dcollens/ZED-80/src/zed-80/lcdsample/README.txt

This folder has the cleaned-up source code for the LCD sample program provided by the panel
manufacturer. The results of running the sample code through the C preprocessor are in RA8876.pp
and can be used to study how the sample program configures the RA8876 registers to achieve
various results.
