dcollens/ZED-80/orders/51846558.xlsx

# | Quantity | Part Number | Manufacturer Part Number | Description | Customer Reference | Backorder | Unit Price | Extended Price
1 | 1 | 269-3898-ND | Z84C0010PEG | IC MPU Z80 10MHZ 40DIP |  | 0 | 7.71 | 7.71
2 | 2 | SST39SF010A-70-4C-PHE-ND | SST39SF010A-70-4C-PHE | IC FLASH 1MBIT 70NS 32DIP |  | 0 | 2.23 | 4.46
3 | 2 | 535-9167-5-ND | ACH-10.000MHZ-EK | OSC XO 10.000MHZ TTL PC PIN |  | 0 | 2.38 | 4.76
4 | 2 | 296-4550-5-ND | SN74AHC14N | IC HEX SCHMITT-TRIG INV 14-DIP |  | 0 | 0.78 | 1.56
5 | 20 | BC2665CT-ND | K104K10X7RF5UH5 | CAP CER 0.1UF 50V X7R RADIAL |  | 0 | 0.177 | 3.54
6 | 10 | BC2662CT-ND | K103K10X7RF5UH5 | CAP CER 10000PF 50V X7R RADIAL |  | 0 | 0.145 | 1.45
7 | 1 | EG4791-ND | KS-01Q-01 | SWITCH PUSH SPST-NO 0.01A 35V |  | 0 | 0.76 | 0.76
8 | 1 | EG4792-ND | KS-01Q-02 | SWITCH PUSH SPST-NO 0.01A 35V |  | 0 | 0.76 | 0.76
9 | 1 | EG4793-ND | KS-01Q-03 | SWITCH PUSH SPST-NO 0.01A 35V |  | 0 | 0.76 | 0.76
10 | 2 | 1450-1017-ND | AS6C1008-55PCN | IC SRAM 1MBIT 55NS 32DIP |  | 0 | 4.55 | 9.10
11 | 2 | 296-4596-5-ND | SN74AHC32N | IC GATE OR 4CH 2-INP 14-DIP |  | 0 | 0.78 | 1.56
12 | 2 | 160-1927-5-ND | LTD-6940HR | LED 7-SEG 2DIGIT HER 0.56" CC |  | 0 | 2.37 | 4.74
13 | 4 | 296-33651-5-ND | SN74AC574N | IC D-TYPE POS TRG SNGL 20DIP |  | 0 | 1.3 | 5.20
14 | 50 | CF18JT220RCT-ND | CF18JT220R | RES 220 OHM 1/8W 5% CF AXIAL |  | 0 | 0.0392 | 1.96
15 | 2 | 296-4542-5-ND | SN74AHC138N | IC 3-8 LINE DECODR/DEMUX 16-DIP |  | 0 | 0.81 | 1.62
16 | 50 | CF18JT10K0CT-ND | CF18JT10K0 | RES 10K OHM 1/8W 5% CF AXIAL |  | 0 | 0.0392 | 1.96
