dcollens/ZED-80/(list of files, cad)

Other CAD files:
lcd-docs/ER-TFTM101-1_8080-8-Bit_With_RTP_SD_Flash_Fontchip(ER3303-1)_DemoCode/sd.OBJ
lcd-docs/ER-TFTM101-1_8080-8-Bit_With_RTP_SD_Flash_Fontchip(ER3303-1)_DemoCode/RA8876.OBJ
