dcollens/ZED-80/lcd-docs/ER-TP101-1_Drawing.pdf

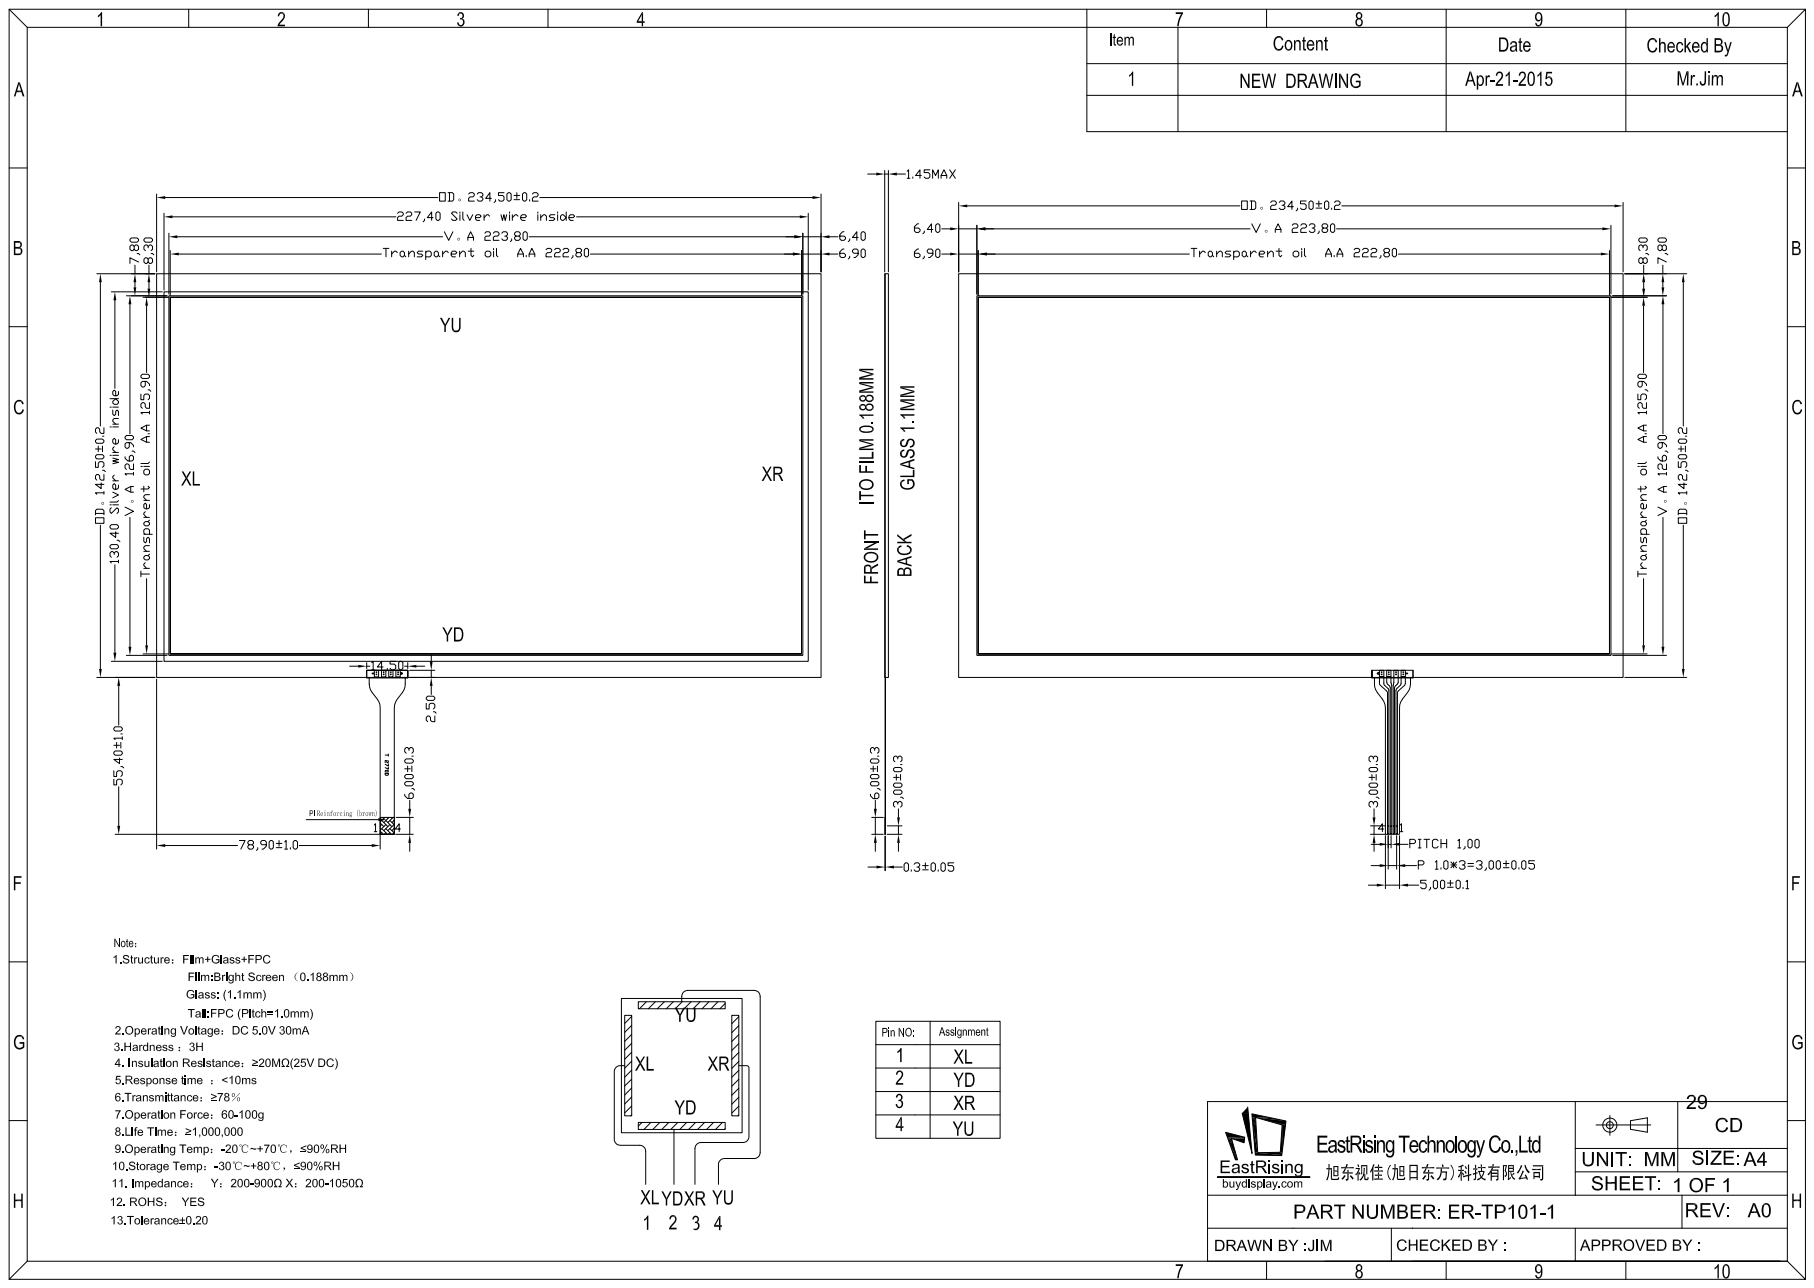
[picture p17: page 1]
