dcollens/ZED-80/kicad/zed-80.kicad_pcb

## KiCad design kicad/zed-80.kicad_pcb (2019-04-16)

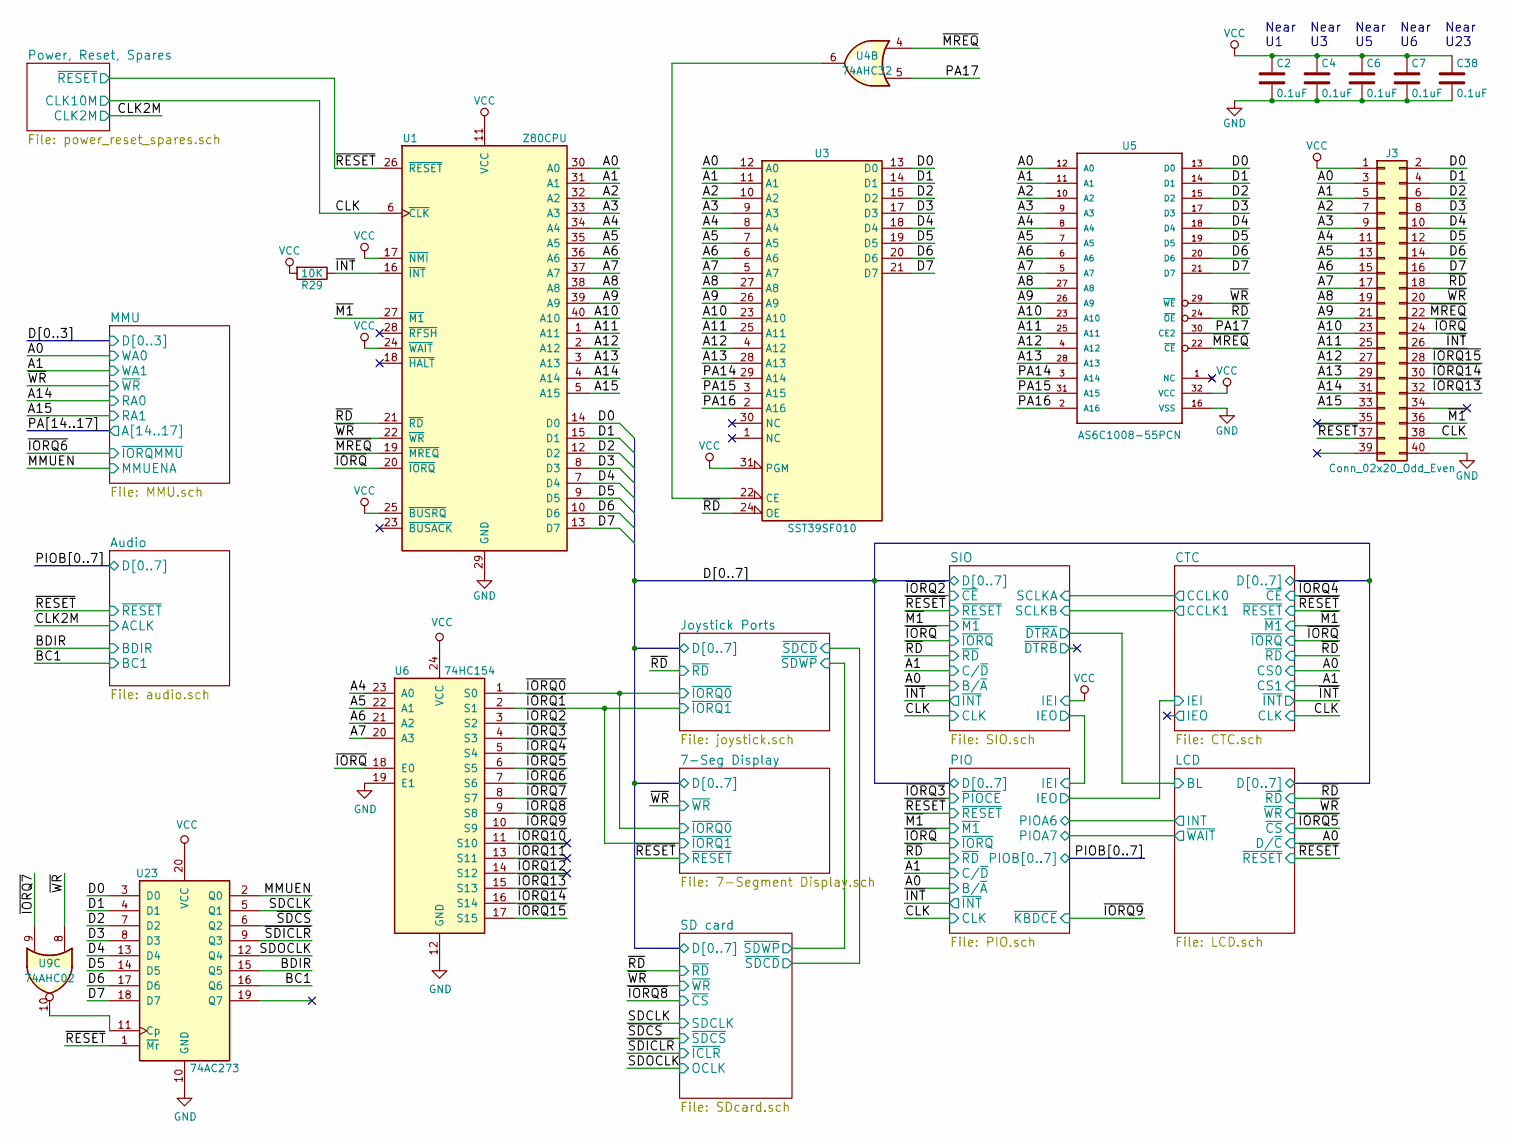
[picture p18: schematic zed-80.sch, ZED-80 Personal Computer]

Parts:
C2, C4, C6, C7, C38: 0.1uF; C_Disc_D4.3mm_W1.9mm_P5.00mm
J3: Conn_02x20_Odd_Even; Pin_Header_Straight_2x20_Pitch2.54mm
R29: 10K; R_0805_HandSoldering
U1: Z80CPU; DIP-40_W15.24mm_Socket
U3: SST39SF010; DIP-32_W15.24mm_Socket
U4: 74AHC32; DIP-14_W7.62mm
U5: AS6C1008-55PCN; DIP-32_W15.24mm_Socket
U6: 74HC154; SOIC-24W_7.5x15.4mm_Pitch1.27mm
U9: 74AHC02; DIP-14_W7.62mm
U23: 74AC273; TSSOP-20_4.4x6.5mm_Pitch0.65mm

Connections:
/A0: J3.3, U1.30 (A0), U3.12 (A0), U5.12 (A0); also elsewhere on the board
/A1: J3.5, U1.31 (A1), U3.11 (A1), U5.11 (A1); also elsewhere on the board
/A2: J3.7, U1.32 (A2), U3.10 (A2), U5.10 (A2)
/A3: J3.9, U1.33 (A3), U3.9 (A3), U5.9 (A3)
/A4: J3.11, U1.34 (A4), U3.8 (A4), U5.8 (A4), U6.23 (A0)
/A5: J3.13, U1.35 (A5), U3.7 (A5), U5.7 (A5), U6.22 (A1)
/A6: J3.15, U1.36 (A6), U3.6 (A6), U5.6 (A6), U6.21 (A2)
/A7: J3.17, U1.37 (A7), U3.5 (A7), U5.5 (A7), U6.20 (A3)
/A8: J3.19, U1.38 (A8), U3.27 (A8), U5.27 (A8)
/A9: J3.21, U1.39 (A9), U3.26 (A9), U5.26 (A9)
/A10: J3.23, U1.40 (A10), U3.23 (A10), U5.23 (A10)
/A11: J3.25, U1.1 (A11), U3.25 (A11), U5.25 (A11)
/A12: J3.27, U1.2 (A12), U3.4 (A12), U5.4 (A12)
/A13: J3.29, U1.3 (A13), U3.28 (A13), U5.28 (A13)
/A14: J3.31, U1.4 (A14); also elsewhere on the board
/A15: J3.33, U1.5 (A15); also elsewhere on the board
/BC1: U23.16 (Q6); also elsewhere on the board
/BDIR: U23.15 (Q5); also elsewhere on the board
/CLK: J3.38, U1.6 (~CLK~); also elsewhere on the board
/D0: J3.2, U1.14 (D0), U3.13 (D0), U5.13 (D0), U23.3 (D0); also elsewhere on the board
/D1: J3.4, U1.15 (D1), U3.14 (D1), U5.14 (D1), U23.4 (D1); also elsewhere on the board
/D2: J3.6, U1.12 (D2), U3.15 (D2), U5.15 (D2), U23.7 (D2); also elsewhere on the board
/D3: J3.8, U1.8 (D3), U3.17 (D3), U5.17 (D3), U23.8 (D3); also elsewhere on the board
/D4: J3.10, U1.7 (D4), U3.18 (D4), U5.18 (D4), U23.13 (D4); also elsewhere on the board
/D5: J3.12, U1.9 (D5), U3.19 (D5), U5.19 (D5), U23.14 (D5); also elsewhere on the board
/D6: J3.14, U1.10 (D6), U3.20 (D6), U5.20 (D6), U23.17 (D6); also elsewhere on the board
/D7: J3.16, U1.13 (D7), U3.21 (D7), U5.21 (D7), U23.18 (D7); also elsewhere on the board
/MMUEN: U23.2 (Q0); also elsewhere on the board
/PA14: U3.29 (A14), U5.3 (A14); also elsewhere on the board
/PA15: U3.3 (A15), U5.31 (A15); also elsewhere on the board
/PA16: U3.2 (A16), U5.2 (A16); also elsewhere on the board
/PA17: U4.5, U5.30 (CE2); also elsewhere on the board
/SDOCLK: U23.12 (Q4); also elsewhere on the board
/~INT: J3.26, R29.1, U1.16 (~INT~); also elsewhere on the board
/~IORQ: J3.24, U1.20 (~IORQ~), U6.18 (E0); also elsewhere on the board
/~IORQ0: U6.1 (S0); also elsewhere on the board
/~IORQ1: U6.2 (S1); also elsewhere on the board
/~IORQ2: U6.3 (S2); also elsewhere on the board
/~IORQ3: U6.4 (S3); also elsewhere on the board
/~IORQ4: U6.5 (S4); also elsewhere on the board
/~IORQ5: U6.6 (S5); also elsewhere on the board
/~IORQ6: U6.7 (S6); also elsewhere on the board
/~IORQ7: U6.8 (S7), U9.9
/~IORQ8: U6.9 (S8); also elsewhere on the board
/~IORQ9: U6.10 (S9); also elsewhere on the board
/~IORQ13: J3.32, U6.15 (S13)
/~IORQ14: J3.30, U6.16 (S14)
/~IORQ15: J3.28, U6.17 (S15)
/~M1: J3.36, U1.27 (~M1~); also elsewhere on the board
/~MREQ: J3.22, U1.19 (~MREQ~), U4.4, U5.22 (~CE)
/~RD: J3.18, U1.21 (~RD~), U3.24 (OE), U5.24 (~OE); also elsewhere on the board
/~RESET: J3.37, U1.26 (~RESET~), U23.1 (~Mr); also elsewhere on the board
/~SDICLR: U23.9 (Q3); also elsewhere on the board
/~WR: J3.20, U1.22 (~WR~), U5.29 (~WE), U9.8; also elsewhere on the board
GND: C2.2, C4.2, C6.2, C7.2, C38.2, J3.40, U1.29 (GND), U3.16 (GND), U5.16 (VSS), U6.12 (GND), U6.19 (E1), U23.10 (GND); also elsewhere on the board
unnamed: U3.22 (CE), U4.6
unnamed: U9.10, U23.11 (Cp)
SDCLK_5V: U23.5 (Q1); also elsewhere on the board
VCC: C2.1, C4.1, C6.1, C7.1, C38.1, J3.1, R29.2, U1.11 (VCC), U1.17 (~NMI~), U1.24 (~WAIT~), U1.25 (~BUSRQ~), U3.31 (PGM), U3.32 (VCC), U5.32 (VCC), U6.24 (VCC), U23.20 (VCC); also elsewhere on the board
~SDCS_5V: U23.6 (Q2); also elsewhere on the board

Notes on the sheet:
Near U1
Near U3
Near U5
Near U6
Near U23

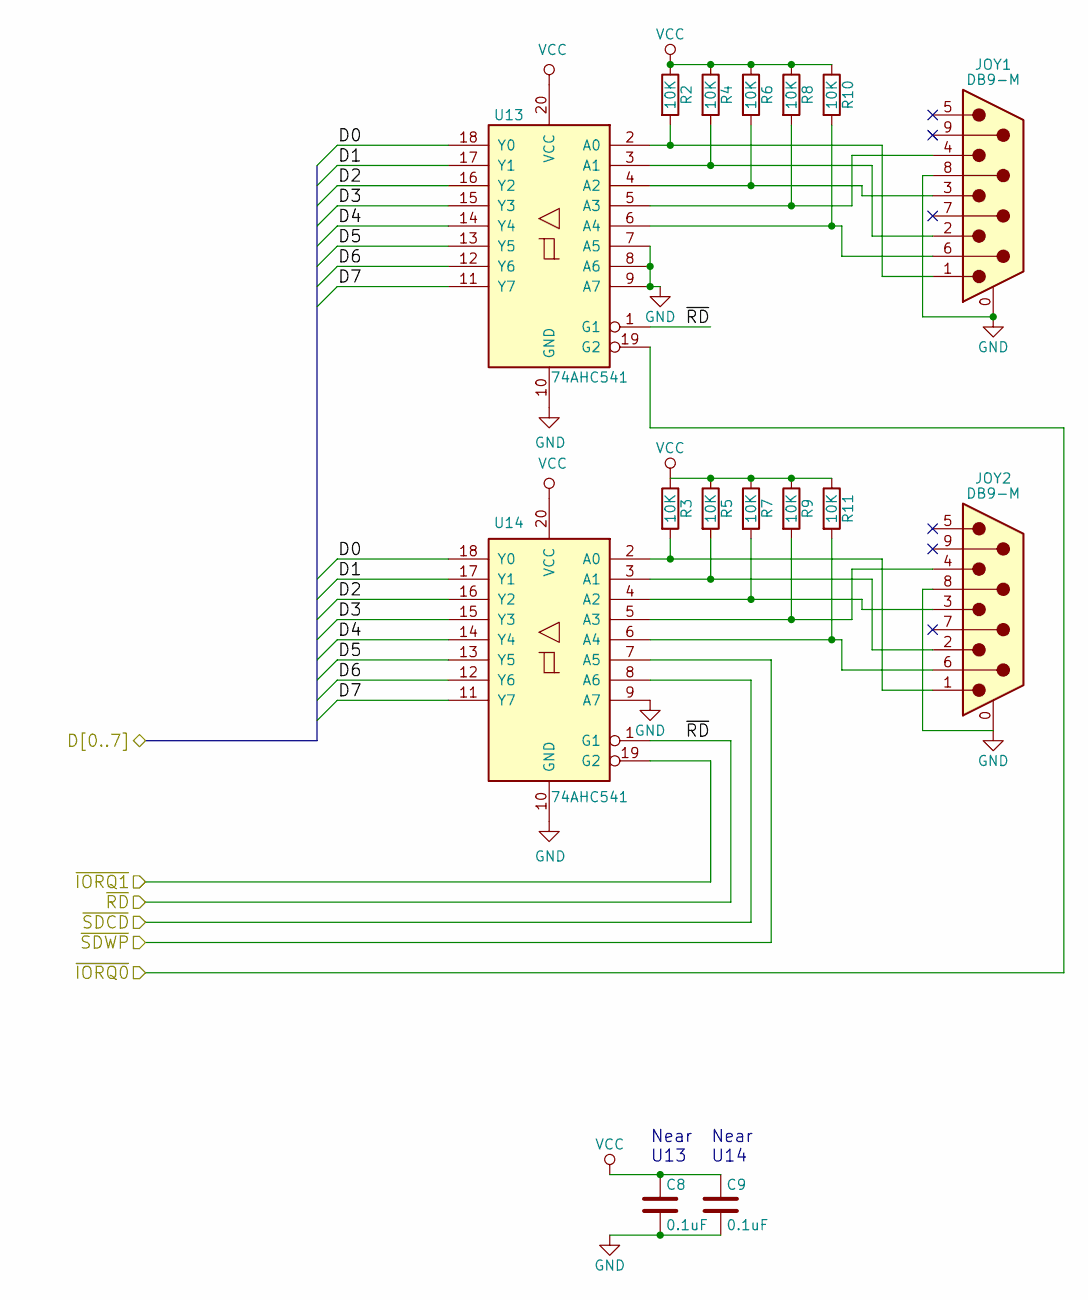
[picture p19: schematic joystick.sch, Joystick Ports]

Parts:
C8, C9: 0.1uF; C_Disc_D4.3mm_W1.9mm_P5.00mm
JOY1, JOY2: DB9-M; L717SDE09P1ACH
R2, R3, R4, R5, R6, R7, R8, R9, R10, R11: 10K; R_0805_HandSoldering
U13, U14: 74AHC541; TSSOP-20_4.4x6.5mm_Pitch0.65mm

Connections:
/D0: U13.18 (Y0), U14.18 (Y0); also elsewhere on the board
/D1: U13.17 (Y1), U14.17 (Y1); also elsewhere on the board
/D2: U13.16 (Y2), U14.16 (Y2); also elsewhere on the board
/D3: U13.15 (Y3), U14.15 (Y3); also elsewhere on the board
/D4: U13.14 (Y4), U14.14 (Y4); also elsewhere on the board
/D5: U13.13 (Y5), U14.13 (Y5); also elsewhere on the board
/D6: U13.12 (Y6), U14.12 (Y6); also elsewhere on the board
/D7: U13.11 (Y7), U14.11 (Y7); also elsewhere on the board
/Joystick Ports/~SDCD: U14.8 (A6); also elsewhere on the board
/Joystick Ports/~SDWP: U14.7 (A5); also elsewhere on the board
/~IORQ0: U13.19 (G2); also elsewhere on the board
/~IORQ1: U14.19 (G2); also elsewhere on the board
/~RD: U13.1 (G1), U14.1 (G1); also elsewhere on the board
GND: C8.2, C9.2, JOY1.0 (PAD), JOY1.8, JOY2.0 (PAD), JOY2.8, U13.7 (A5), U13.8 (A6), U13.9 (A7), U13.10 (GND), U14.9 (A7), U14.10 (GND); also elsewhere on the board
unnamed: JOY1.1, R2.2, U13.2 (A0)
unnamed: JOY1.2, R4.2, U13.3 (A1)
unnamed: JOY1.3, R6.2, U13.4 (A2)
unnamed: JOY1.4, R8.2, U13.5 (A3)
unnamed: JOY1.6, R10.2, U13.6 (A4)
unnamed: JOY2.1, R3.2, U14.2 (A0)
unnamed: JOY2.2, R5.2, U14.3 (A1)
unnamed: JOY2.3, R7.2, U14.4 (A2)
unnamed: JOY2.4, R9.2, U14.5 (A3)
unnamed: JOY2.6, R11.2, U14.6 (A4)
VCC: C8.1, C9.1, R2.1, R3.1, R4.1, R5.1, R6.1, R7.1, R8.1, R9.1, R10.1, R11.1, U13.20 (VCC), U14.20 (VCC); also elsewhere on the board

Notes on the sheet:
Near U13
Near U14

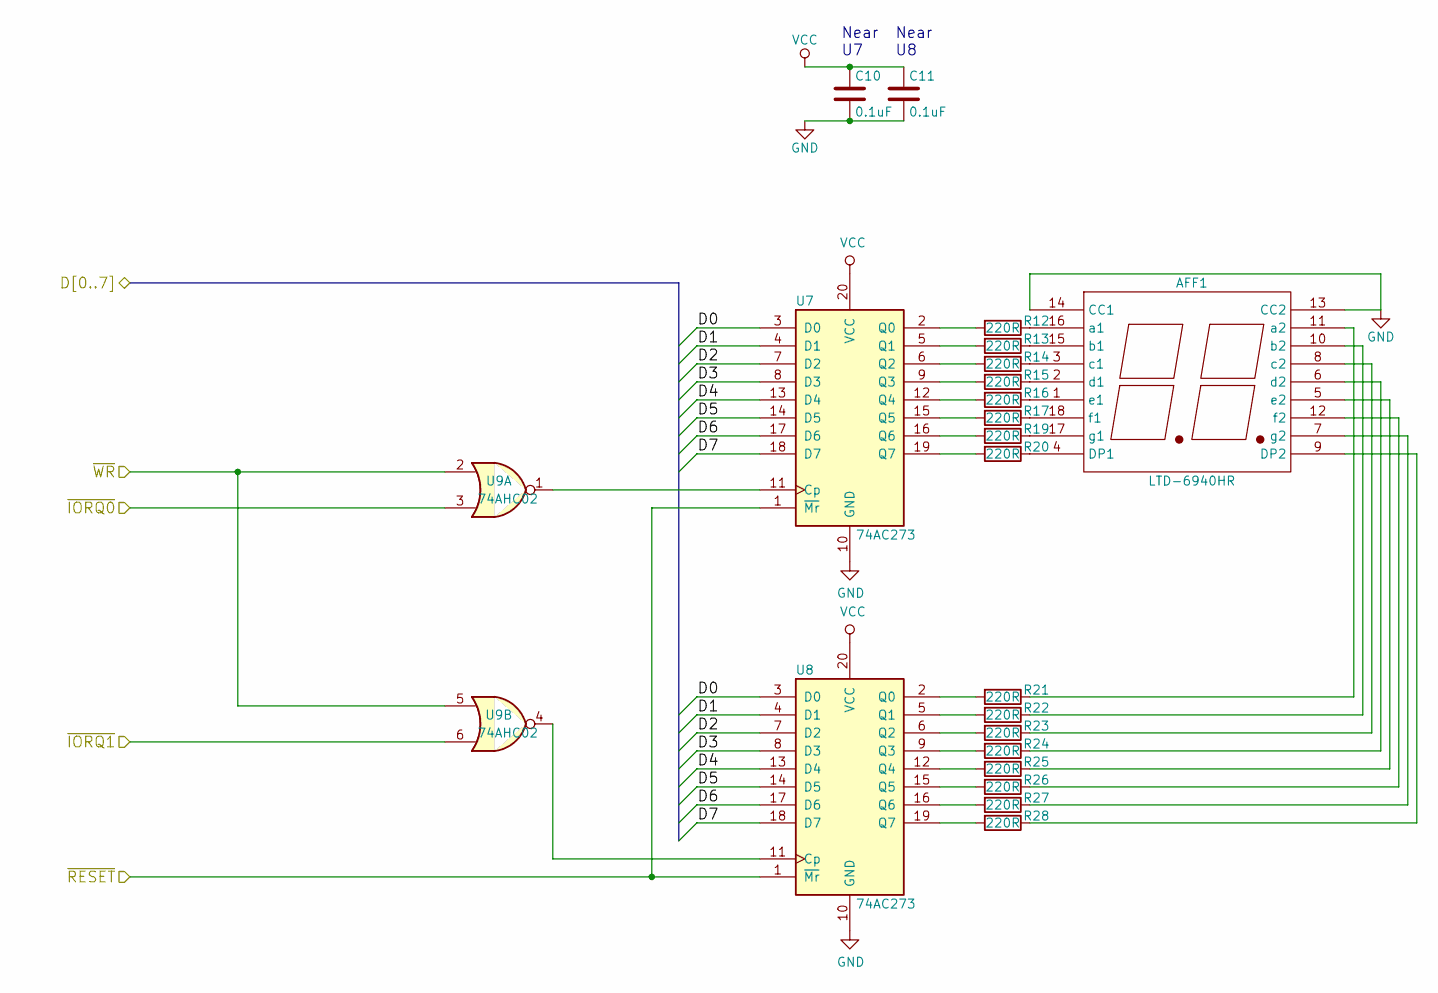
[picture p20: schematic 7-Segment Display.sch]

Parts:
AFF1: LTD-6940HR
C10, C11: 0.1uF; C_Disc_D4.3mm_W1.9mm_P5.00mm
R12, R13, R14, R15, R16, R17, R19, R20, R21, R22, R23, R24, R25, R26, R27, R28: 220R; R_Axial_DIN0204_L3.6mm_D1.6mm_P5.08mm_Horizontal
U7, U8: 74AC273; TSSOP-20_4.4x6.5mm_Pitch0.65mm
U9: 74AHC02; DIP-14_W7.62mm

Connections:
/D0: U7.3 (D0), U8.3 (D0); also elsewhere on the board
/D1: U7.4 (D1), U8.4 (D1); also elsewhere on the board
/D2: U7.7 (D2), U8.7 (D2); also elsewhere on the board
/D3: U7.8 (D3), U8.8 (D3); also elsewhere on the board
/D4: U7.13 (D4), U8.13 (D4); also elsewhere on the board
/D5: U7.14 (D5), U8.14 (D5); also elsewhere on the board
/D6: U7.17 (D6), U8.17 (D6); also elsewhere on the board
/D7: U7.18 (D7), U8.18 (D7); also elsewhere on the board
/~IORQ0: U9.3; also elsewhere on the board
/~IORQ1: U9.6; also elsewhere on the board
/~RESET: U7.1 (~Mr), U8.1 (~Mr); also elsewhere on the board
/~WR: U9.2, U9.5; also elsewhere on the board
GND: AFF1.13 (CC2), AFF1.14 (CC1), C10.2, C11.2, U7.10 (GND), U8.10 (GND); also elsewhere on the board
unnamed: AFF1.1 (e1), R16.1
unnamed: AFF1.2 (d1), R15.1
unnamed: AFF1.3 (c1), R14.1
unnamed: AFF1.4 (DP1), R20.1
unnamed: AFF1.5 (e2), R25.1
unnamed: AFF1.6 (d2), R24.1
unnamed: AFF1.7 (g2), R27.1
unnamed: AFF1.8 (c2), R23.1
unnamed: AFF1.9 (DP2), R28.1
unnamed: AFF1.10 (b2), R22.1
unnamed: AFF1.11 (a2), R21.1
unnamed: AFF1.12 (f2), R26.1
unnamed: AFF1.15 (b1), R13.1
unnamed: AFF1.16 (a1), R12.1
unnamed: AFF1.17 (g1), R19.1
unnamed: AFF1.18 (f1), R17.1
unnamed: R12.2, U7.2 (Q0)
unnamed: R13.2, U7.5 (Q1)
unnamed: R14.2, U7.6 (Q2)
unnamed: R15.2, U7.9 (Q3)
unnamed: R16.2, U7.12 (Q4)
unnamed: R17.2, U7.15 (Q5)
unnamed: R19.2, U7.16 (Q6)
unnamed: R20.2, U7.19 (Q7)
unnamed: R21.2, U8.2 (Q0)
unnamed: R22.2, U8.5 (Q1)
unnamed: R23.2, U8.6 (Q2)
unnamed: R24.2, U8.9 (Q3)
unnamed: R25.2, U8.12 (Q4)
unnamed: R26.2, U8.15 (Q5)
unnamed: R27.2, U8.16 (Q6)
unnamed: R28.2, U8.19 (Q7)
unnamed: U7.11 (Cp), U9.1
unnamed: U8.11 (Cp), U9.4
VCC: C10.1, C11.1, U7.20 (VCC), U8.20 (VCC); also elsewhere on the board

Notes on the sheet:
Near U7
Near U8

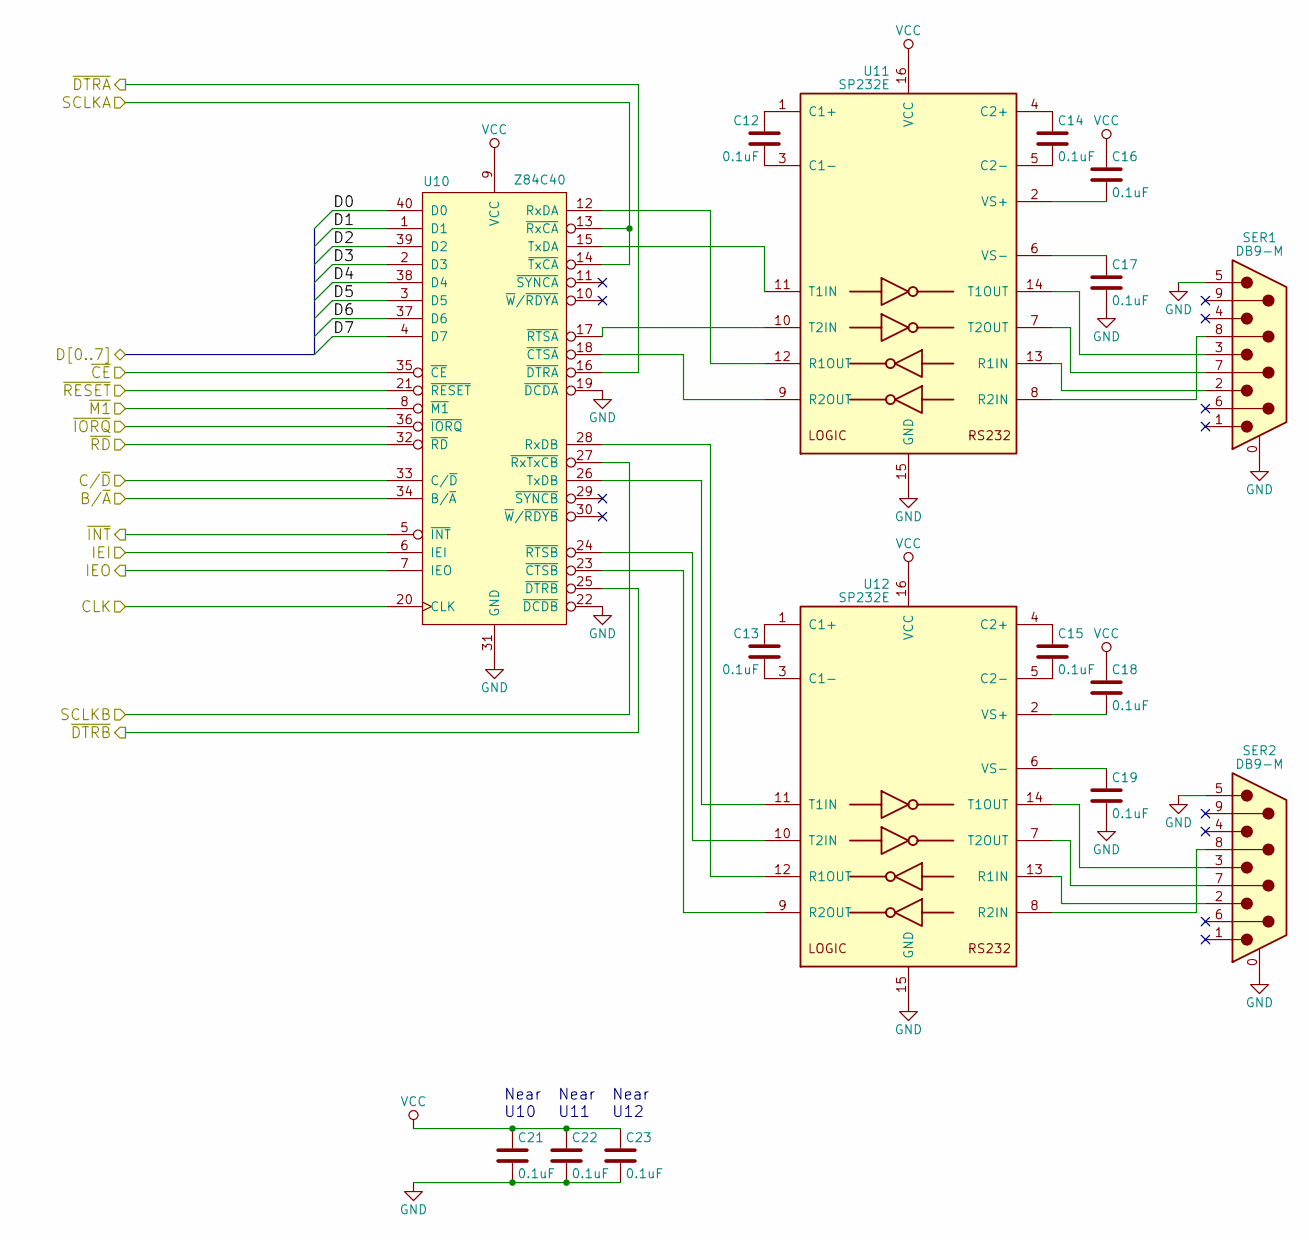
[picture p21: schematic SIO.sch, Serial Ports]

Parts:
C12, C13, C14, C15, C16, C17, C18, C19, C21, C22, C23: 0.1uF; C_Disc_D4.3mm_W1.9mm_P5.00mm
SER1, SER2: DB9-M; L717SDE09P1ACH
U10: Z84C40; DIP-40_W15.24mm_Socket
U11, U12: SP232E; DIP-16_W7.62mm

Connections:
/A0: U10.34 (B/~A); also elsewhere on the board
/A1: U10.33 (C/~D); also elsewhere on the board
/CLK: U10.20 (CLK); also elsewhere on the board
/CTC/CCLK0: U10.13 (~RxCA), U10.14 (~TxCA); also elsewhere on the board
/CTC/CCLK1: U10.27 (~RxTxCB); also elsewhere on the board
/D0: U10.40 (D0); also elsewhere on the board
/D1: U10.1 (D1); also elsewhere on the board
/D2: U10.39 (D2); also elsewhere on the board
/D3: U10.2 (D3); also elsewhere on the board
/D4: U10.38 (D4); also elsewhere on the board
/D5: U10.3 (D5); also elsewhere on the board
/D6: U10.37 (D6); also elsewhere on the board
/D7: U10.4 (D7); also elsewhere on the board
/LCD/BL: U10.16 (~DTRA); also elsewhere on the board
/PIO/IEI: U10.7 (IEO); also elsewhere on the board
/~INT: U10.5 (~INT); also elsewhere on the board
/~IORQ: U10.36 (~IORQ); also elsewhere on the board
/~IORQ2: U10.35 (~CE); also elsewhere on the board
/~M1: U10.8 (~M1); also elsewhere on the board
/~RD: U10.32 (~RD); also elsewhere on the board
/~RESET: U10.21 (~RESET); also elsewhere on the board
GND: C17.2, C19.2, C21.2, C22.2, C23.2, SER1.0 (PAD), SER1.5, SER2.0 (PAD), SER2.5, U10.19 (~DCDA), U10.22 (~DCDB), U10.31 (GND), U11.15 (GND), U12.15 (GND); also elsewhere on the board
unnamed: C12.1, U11.1 (C1+)
unnamed: C12.2, U11.3 (C1-)
unnamed: C13.1, U12.1 (C1+)
unnamed: C13.2, U12.3 (C1-)
unnamed: C14.1, U11.4 (C2+)
unnamed: C14.2, U11.5 (C2-)
unnamed: C15.1, U12.4 (C2+)
unnamed: C15.2, U12.5 (C2-)
unnamed: C16.2, U11.2 (VS+)
unnamed: C17.1, U11.6 (VS-)
unnamed: C18.2, U12.2 (VS+)
unnamed: C19.1, U12.6 (VS-)
unnamed: SER1.2, U11.13 (R1IN)
unnamed: SER1.3, U11.14 (T1OUT)
unnamed: SER1.7, U11.7 (T2OUT)
unnamed: SER1.8, U11.8 (R2IN)
unnamed: SER2.2, U12.13 (R1IN)
unnamed: SER2.3, U12.14 (T1OUT)
unnamed: SER2.7, U12.7 (T2OUT)
unnamed: SER2.8, U12.8 (R2IN)
unnamed: U10.12 (RxDA), U11.12 (R1OUT)
unnamed: U10.15 (TxDA), U11.11 (T1IN)
unnamed: U10.17 (~RTSA), U11.10 (T2IN)
unnamed: U10.18 (~CTSA), U11.9 (R2OUT)
unnamed: U10.23 (~CTSB), U12.9 (R2OUT)
unnamed: U10.24 (~RTSB), U12.10 (T2IN)
unnamed: U10.26 (TxDB), U12.11 (T1IN)
unnamed: U10.28 (RxDB), U12.12 (R1OUT)
VCC: C16.1, C18.1, C21.1, C22.1, C23.1, U10.6 (IEI), U10.9 (VCC), U11.16 (VCC), U12.16 (VCC); also elsewhere on the board

Notes on the sheet:
Near U10
Near U11
Near U12

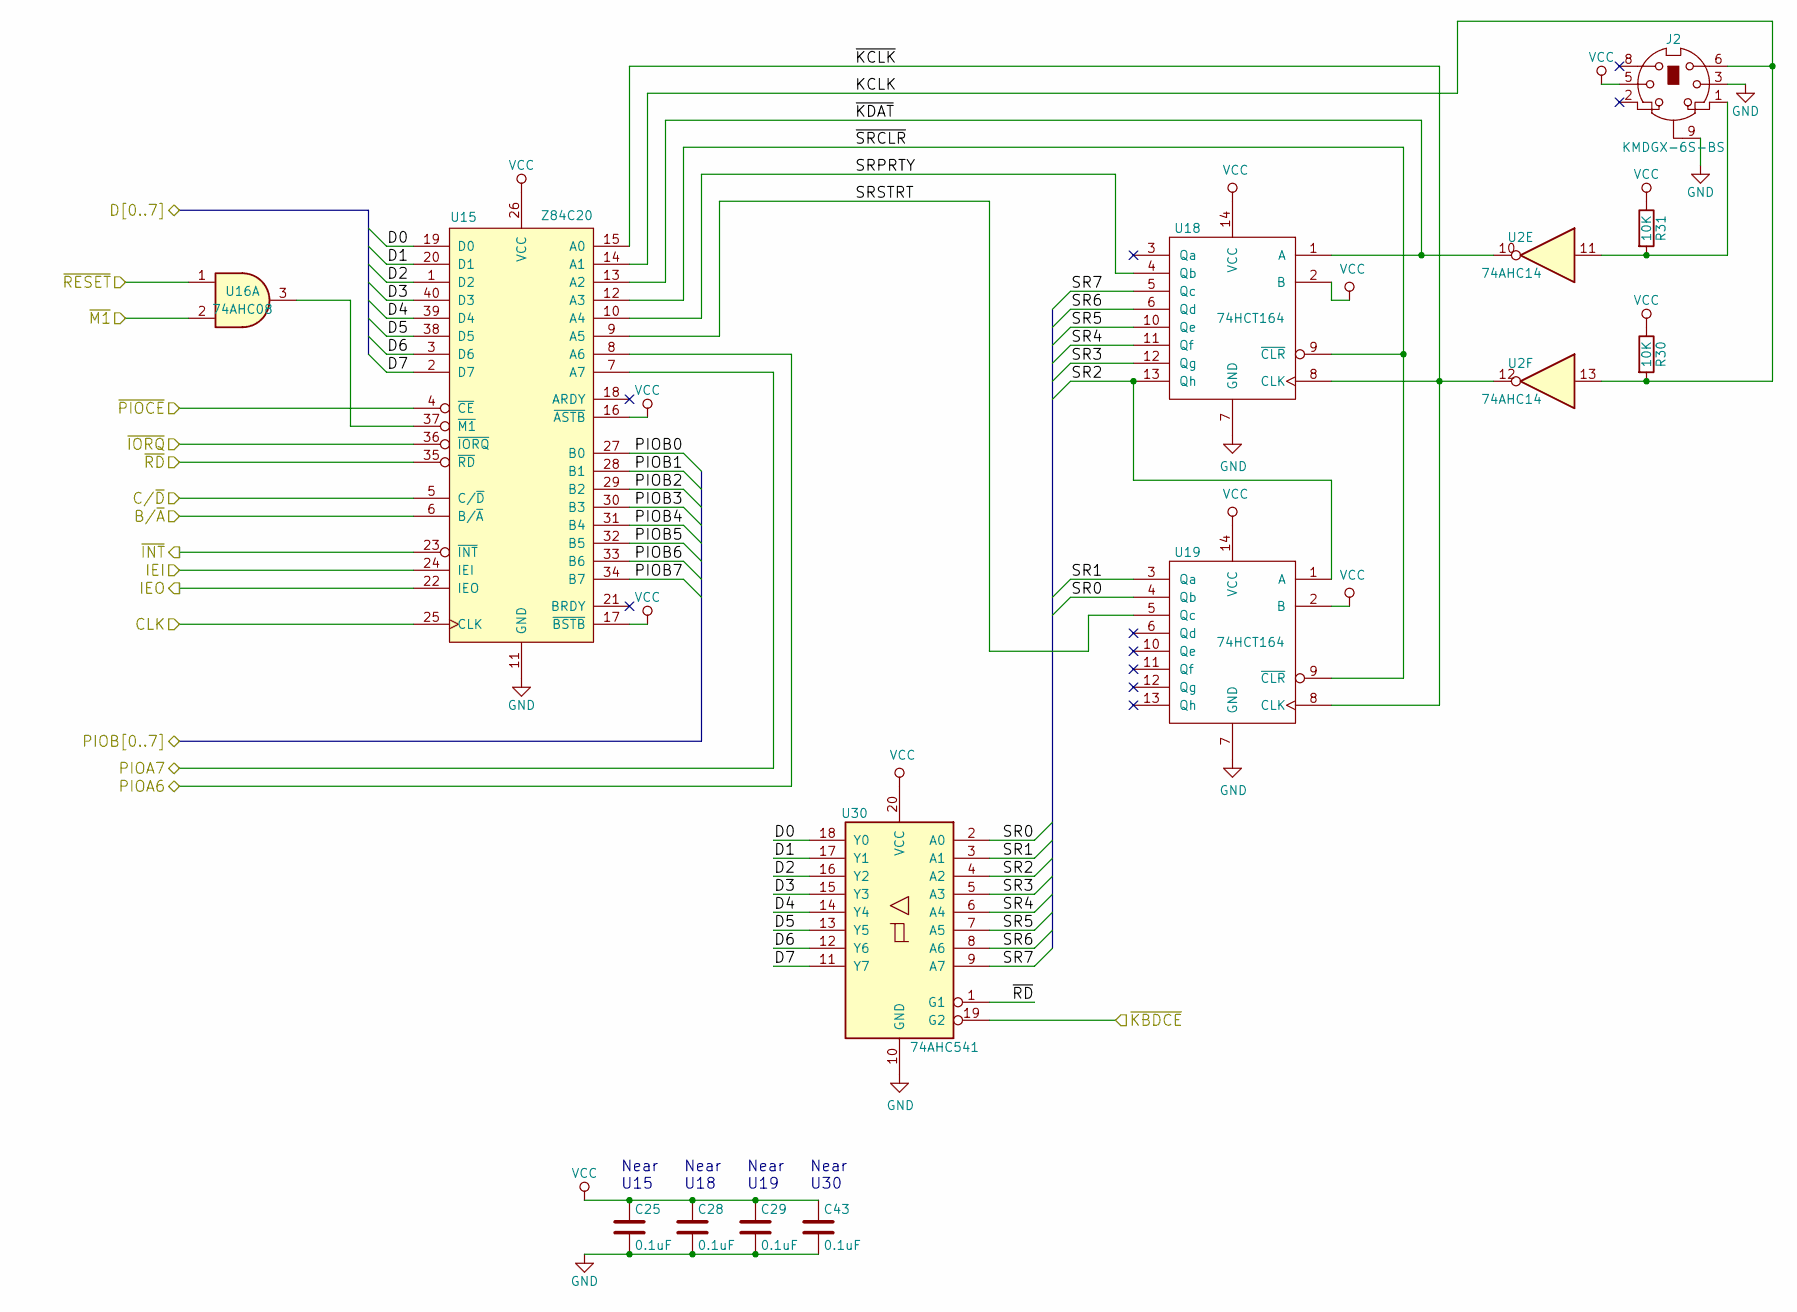
[picture p22: schematic PIO.sch, PIO, PS/2 Keyboard Port]

Parts:
C25, C28, C29, C43: 0.1uF; C_Disc_D4.3mm_W1.9mm_P5.00mm
J2: KMDGX-6S-BS
R30, R31: 10K; R_0805_HandSoldering
U2: 74AHC14; DIP-14_W7.62mm
U15: Z84C20; DIP-40_W15.24mm_Socket
U16: 74AHC08; DIP-14_W7.62mm
U18, U19: 74HCT164; TSSOP-14_4.4x5mm_Pitch0.65mm
U30: 74AHC541; TSSOP-20_4.4x6.5mm_Pitch0.65mm

Connections:
/A0: U15.6 (B/~A); also elsewhere on the board
/A1: U15.5 (C/~D); also elsewhere on the board
/Audio/D0: U15.27 (B0); also elsewhere on the board
/Audio/D1: U15.28 (B1); also elsewhere on the board
/Audio/D2: U15.29 (B2); also elsewhere on the board
/Audio/D3: U15.30 (B3); also elsewhere on the board
/Audio/D4: U15.31 (B4); also elsewhere on the board
/Audio/D5: U15.32 (B5); also elsewhere on the board
/Audio/D6: U15.33 (B6); also elsewhere on the board
/Audio/D7: U15.34 (B7); also elsewhere on the board
/CLK: U15.25 (CLK); also elsewhere on the board
/CTC/IEI: U15.22 (IEO); also elsewhere on the board
/D0: U15.19 (D0), U30.18 (Y0); also elsewhere on the board
/D1: U15.20 (D1), U30.17 (Y1); also elsewhere on the board
/D2: U15.1 (D2), U30.16 (Y2); also elsewhere on the board
/D3: U15.40 (D3), U30.15 (Y3); also elsewhere on the board
/D4: U15.39 (D4), U30.14 (Y4); also elsewhere on the board
/D5: U15.38 (D5), U30.13 (Y5); also elsewhere on the board
/D6: U15.3 (D6), U30.12 (Y6); also elsewhere on the board
/D7: U15.2 (D7), U30.11 (Y7); also elsewhere on the board
/LCD/INT: U15.8 (A6); also elsewhere on the board
/PIO/IEI: U15.24 (IEI); also elsewhere on the board
/PIO/KCLK: J2.6, R30.2, U2.13, U15.14 (A1)
/PIO/PIOA7: U15.7 (A7); also elsewhere on the board
/PIO/SR0: U19.4 (Qb), U30.2 (A0)
/PIO/SR1: U19.3 (Qa), U30.3 (A1)
/PIO/SR2: U18.13 (Qh), U19.1 (A), U30.4 (A2)
/PIO/SR3: U18.12 (Qg), U30.5 (A3)
/PIO/SR4: U18.11 (Qf), U30.6 (A4)
/PIO/SR5: U18.10 (Qe), U30.7 (A5)
/PIO/SR6: U18.6 (Qd), U30.8 (A6)
/PIO/SR7: U18.5 (Qc), U30.9 (A7)
/PIO/SRPRTY: U15.10 (A4), U18.4 (Qb)
/PIO/SRSTRT: U15.9 (A5), U19.5 (Qc)
/PIO/~KCLK: U2.12, U15.15 (A0), U18.8 (CLK), U19.8 (CLK)
/PIO/~KDAT: U2.10, U15.13 (A2), U18.1 (A)
/PIO/~SRCLR: U15.12 (A3), U18.9 (~CLR), U19.9 (~CLR)
/~INT: U15.23 (~INT); also elsewhere on the board
/~IORQ: U15.36 (~IORQ); also elsewhere on the board
/~IORQ3: U15.4 (~CE); also elsewhere on the board
/~IORQ9: U30.19 (G2); also elsewhere on the board
/~M1: U16.2; also elsewhere on the board
/~RD: U15.35 (~RD), U30.1 (G1); also elsewhere on the board
/~RESET: U16.1; also elsewhere on the board
GND: C25.2, C28.2, C29.2, C43.2, J2.3, J2.9, U15.11 (GND), U18.7 (GND), U19.7 (GND), U30.10 (GND); also elsewhere on the board
unnamed: J2.1, R31.2, U2.11
unnamed: U15.37 (~M1), U16.3
VCC: C25.1, C28.1, C29.1, C43.1, J2.5, R30.1, R31.1, U15.16 (~ASTB), U15.17 (~BSTB), U15.26 (VCC), U18.2 (B), U18.14 (VCC), U19.2 (B), U19.14 (VCC), U30.20 (VCC); also elsewhere on the board

Notes on the sheet:
Near U15
Near U18
Near U19
Near U30

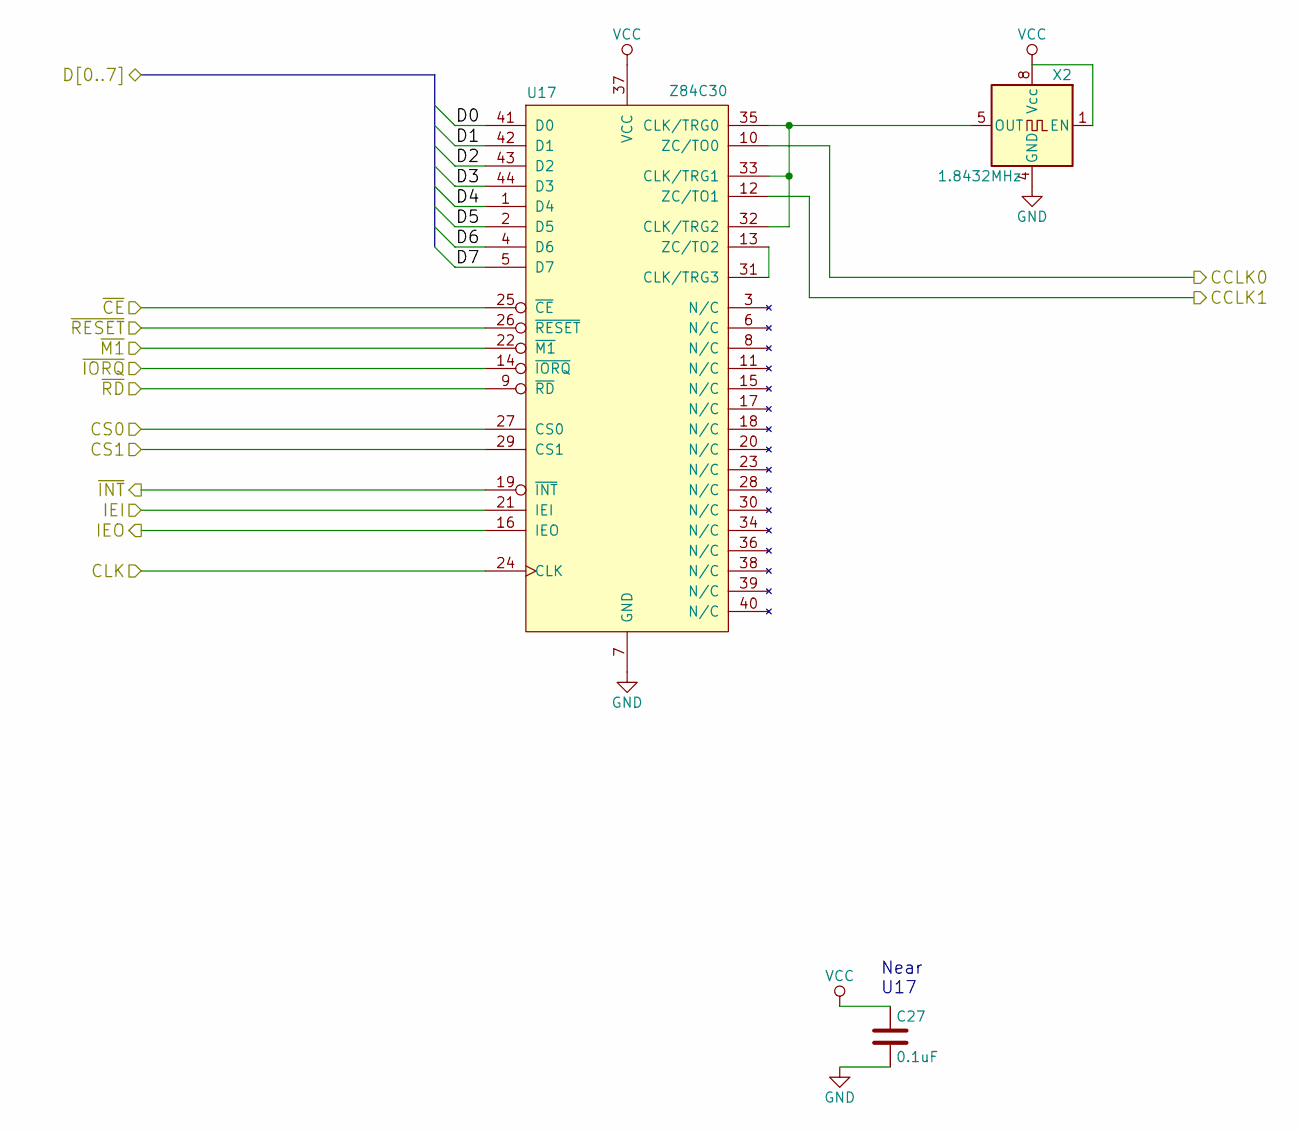
[picture p23: schematic CTC.sch, Timers, Baud Rate Generation]

Parts:
C27: 0.1uF; C_Disc_D4.3mm_W1.9mm_P5.00mm
U17: Z84C30; 8444-11B1-RK-TP
X2: 1.8432MHz; Oscillator_DIP-8

Connections:
/A0: U17.27 (CS0); also elsewhere on the board
/A1: U17.29 (CS1); also elsewhere on the board
/CLK: U17.24 (CLK); also elsewhere on the board
/CTC/CCLK0: U17.10 (ZC/TO0); also elsewhere on the board
/CTC/CCLK1: U17.12 (ZC/TO1); also elsewhere on the board
/CTC/IEI: U17.21 (IEI); also elsewhere on the board
/D0: U17.41 (D0); also elsewhere on the board
/D1: U17.42 (D1); also elsewhere on the board
/D2: U17.43 (D2); also elsewhere on the board
/D3: U17.44 (D3); also elsewhere on the board
/D4: U17.1 (D4); also elsewhere on the board
/D5: U17.2 (D5); also elsewhere on the board
/D6: U17.4 (D6); also elsewhere on the board
/D7: U17.5 (D7); also elsewhere on the board
/~INT: U17.19 (~INT); also elsewhere on the board
/~IORQ: U17.14 (~IORQ); also elsewhere on the board
/~IORQ4: U17.25 (~CE); also elsewhere on the board
/~M1: U17.22 (~M1); also elsewhere on the board
/~RD: U17.9 (~RD); also elsewhere on the board
/~RESET: U17.26 (~RESET); also elsewhere on the board
GND: C27.2, U17.7 (GND), X2.4 (GND); also elsewhere on the board
unnamed: U17.13 (ZC/TO2), U17.31 (CLK/TRG3)
unnamed: U17.32 (CLK/TRG2), U17.33 (CLK/TRG1), U17.35 (CLK/TRG0), X2.5 (OUT)
VCC: C27.1, U17.37 (VCC), X2.1 (EN), X2.8 (Vcc); also elsewhere on the board

Notes on the sheet:
Near U17

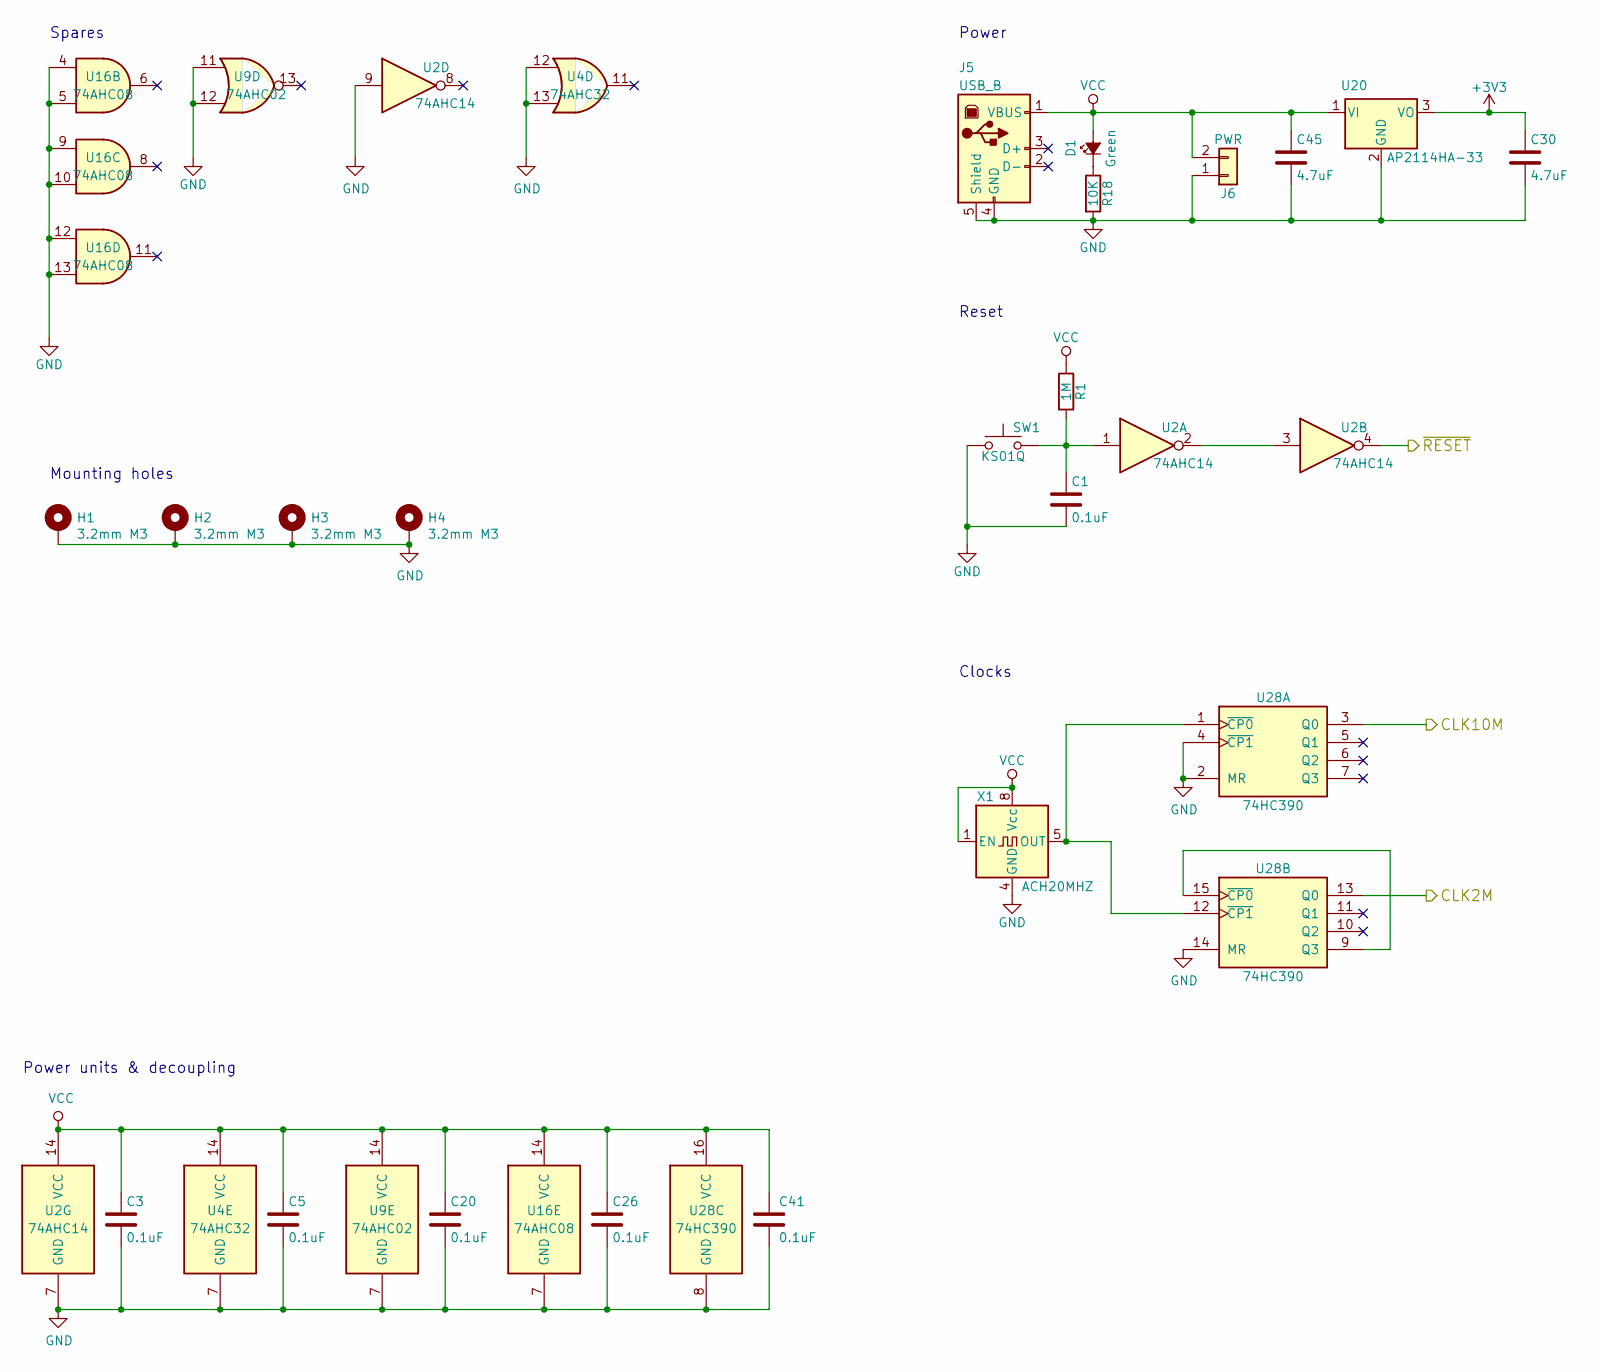
[picture p24: schematic power_reset_spares.sch, Power, reset, and spares]

Parts:
C1, C3, C5, C20, C26, C41: 0.1uF; C_Disc_D4.3mm_W1.9mm_P5.00mm
C30, C45: 4.7uF; C_0805_HandSoldering
D1: Green; LED_D5.0mm
H1, H2, H3, H4: 3.2mm M3; MountingHole_3.2mm_M3_Pad
J5: USB_B; USB_B_E8144-B02022-L
J6: PWR; Pin_Header_Straight_2x01_Pitch2.54mm
R1: 1M; R_Axial_DIN0204_L3.6mm_D1.6mm_P5.08mm_Horizontal
R18: 10K; R_0805_HandSoldering
SW1: KS01Q; KS-01Q-02
U2: 74AHC14; DIP-14_W7.62mm
U4: 74AHC32; DIP-14_W7.62mm
U9: 74AHC02; DIP-14_W7.62mm
U16: 74AHC08; DIP-14_W7.62mm
U20: AP2114HA-33; SOT-223-3_TabPin2
U28: 74HC390; TSSOP-16_4.4x5mm_Pitch0.65mm
X1: ACH20MHZ; Oscillator_DIP-8

Connections:
+3V3: C30.1, U20.3 (VO); also elsewhere on the board
/CLK: U28.3 (Q0); also elsewhere on the board
/CLK2M: U28.13 (Q0); also elsewhere on the board
/~RESET: U2.4; also elsewhere on the board
GND: C1.2, C3.2, C5.2, C20.2, C26.2, C30.2, C41.2, C45.2, H1.1, H2.1, H3.1, H4.1, J5.4 (GND), J5.5 (Shield), J6.1, R18.2, SW1.1, U2.7 (GND), U2.9, U4.7 (GND), U4.12, U4.13, U9.7 (GND), U9.11, U9.12, U16.4, U16.5, U16.7 (GND), U16.9, U16.10, U16.12, U16.13, U20.2 (GND), U28.2 (MR), U28.4 (~CP1), U28.8 (GND), U28.14 (MR), X1.4 (GND); also elsewhere on the board
unnamed: C1.1, R1.2, SW1.2, U2.1
unnamed: D1.1 (K), R18.1
unnamed: U2.2, U2.3
unnamed: U28.1 (~CP0), U28.12 (~CP1), X1.5 (OUT)
unnamed: U28.9 (Q3), U28.15 (~CP0)
VCC: C3.1, C5.1, C20.1, C26.1, C41.1, C45.1, D1.2 (A), J5.1 (VBUS), J6.2, R1.1, U2.14 (VCC), U4.14 (VCC), U9.14 (VCC), U16.14 (VCC), U20.1 (VI), U28.16 (VCC), X1.1 (EN), X1.8 (Vcc); also elsewhere on the board

Notes on the sheet:
Spares
Power units & decoupling
Power
Reset
Clocks
Mounting holes
