dcollens/ZED-80/kicad/zed-80.kicad_pcb

## KiCad design kicad/zed-80.kicad_pcb (continued)

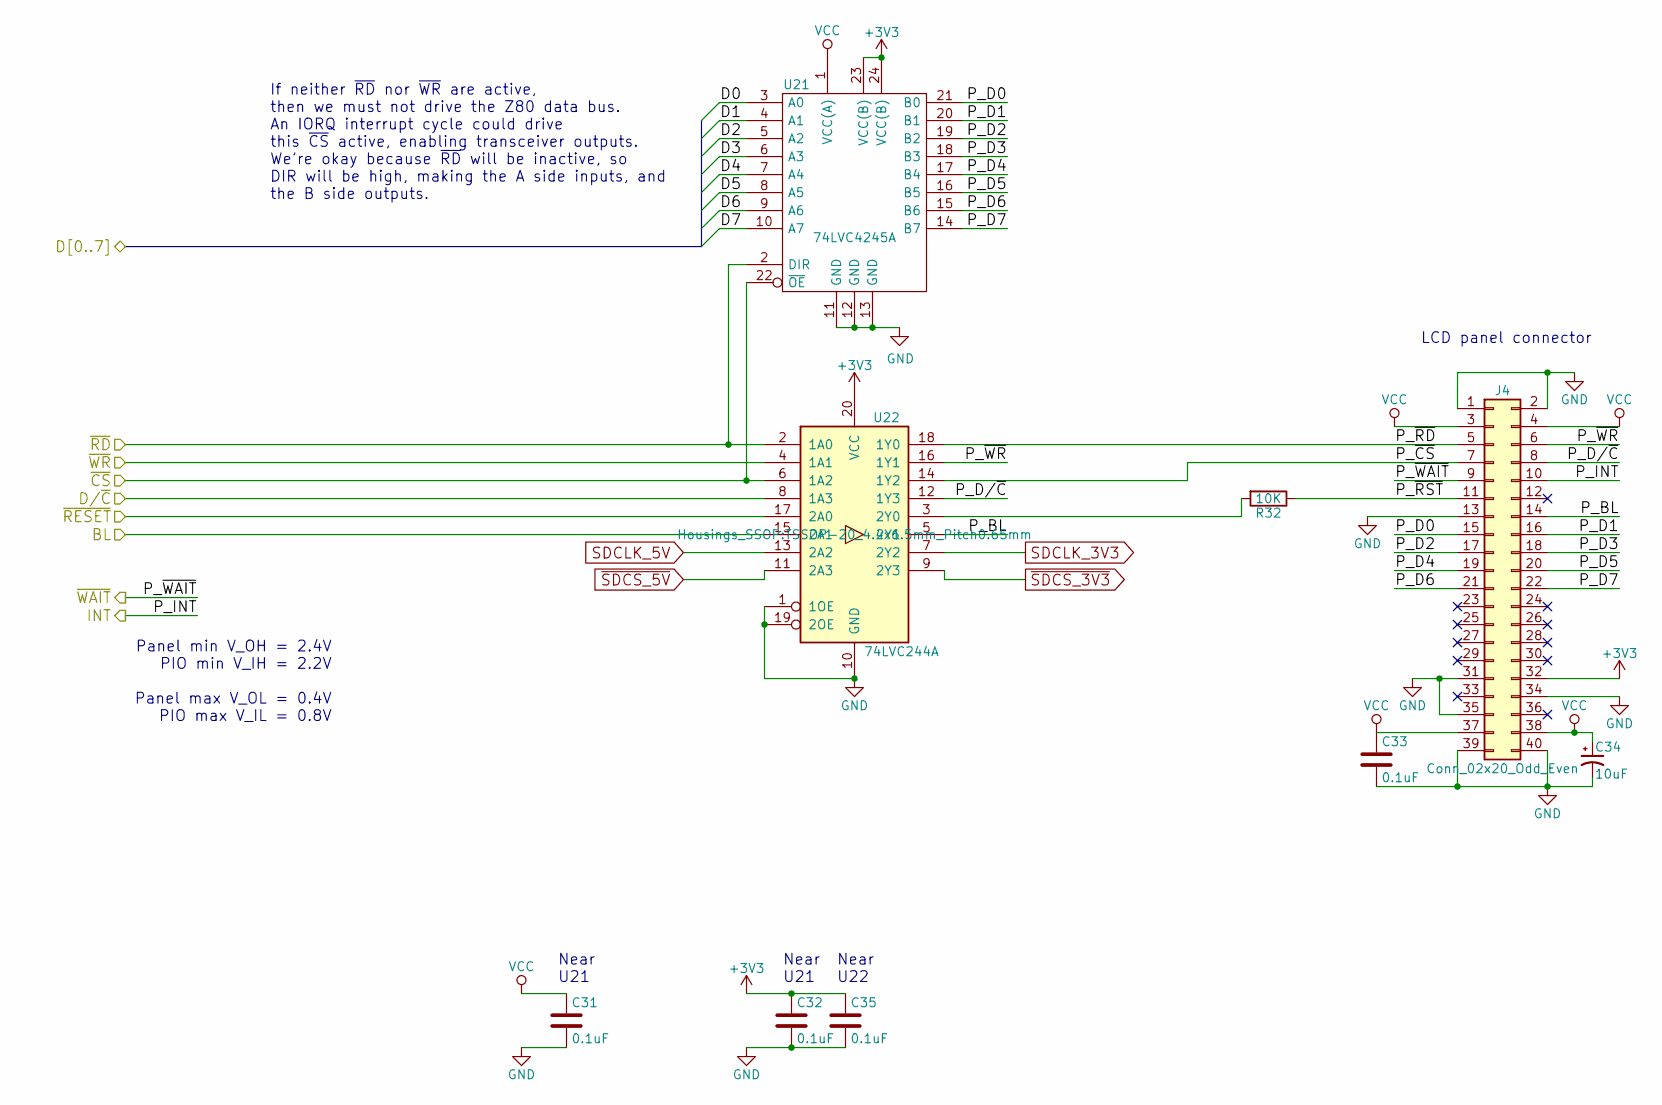
[picture p25: schematic LCD.sch, LCD Interface]

Parts:
C31, C32, C33, C35: 0.1uF; C_Disc_D4.3mm_W1.9mm_P5.00mm
C34: 10uF; CP_Radial_D5.0mm_P2.50mm
J4: Conn_02x20_Odd_Even; Pin_Header_Straight_2x20_Pitch2.54mm
R32: 10K; R_0805_HandSoldering
U21: 74LVC4245A; TSSOP-24_4.4x7.8mm_Pitch0.65mm
U22: 74LVC244A; TSSOP-20_4.4x6.5mm_Pitch0.65mm

Connections:
+3V3: C32.1, C35.1, J4.32, U21.23 (VCC(B)), U21.24 (VCC(B)), U22.20 (VCC); also elsewhere on the board
/A0: U22.8 (1A3); also elsewhere on the board
/D0: U21.3 (A0); also elsewhere on the board
/D1: U21.4 (A1); also elsewhere on the board
/D2: U21.5 (A2); also elsewhere on the board
/D3: U21.6 (A3); also elsewhere on the board
/D4: U21.7 (A4); also elsewhere on the board
/D5: U21.8 (A5); also elsewhere on the board
/D6: U21.9 (A6); also elsewhere on the board
/D7: U21.10 (A7); also elsewhere on the board
/LCD/BL: U22.15 (2A1); also elsewhere on the board
/LCD/INT: J4.10; also elsewhere on the board
/LCD/P_BL: J4.14, U22.5 (2Y1)
/LCD/P_D0: J4.15, U21.21 (B0)
/LCD/P_D1: J4.16, U21.20 (B1)
/LCD/P_D2: J4.17, U21.19 (B2)
/LCD/P_D3: J4.18, U21.18 (B3)
/LCD/P_D4: J4.19, U21.17 (B4)
/LCD/P_D5: J4.20, U21.16 (B5)
/LCD/P_D6: J4.21, U21.15 (B6)
/LCD/P_D7: J4.22, U21.14 (B7)
/LCD/P_D/~C: J4.8, U22.12 (1Y3)
/LCD/P_~CS: J4.7, U22.14 (1Y2)
/LCD/P_~RD: J4.5, U22.18 (1Y0)
/LCD/P_~RST: J4.11, R32.1
/LCD/P_~WR: J4.6, U22.16 (1Y1)
/PIO/PIOA7: J4.9; also elsewhere on the board
/~IORQ5: U21.22 (~OE), U22.6 (1A2); also elsewhere on the board
/~RD: U21.2 (DIR), U22.2 (1A0); also elsewhere on the board
/~RESET: U22.17 (2A0); also elsewhere on the board
/~WR: U22.4 (1A1); also elsewhere on the board
GND: C31.2, C32.2, C33.2, C34.2, C35.2, J4.1, J4.2, J4.13, J4.31, J4.34, J4.35, J4.39, J4.40, U21.11 (GND), U21.12 (GND), U21.13 (GND), U22.1 (1OE), U22.10 (GND), U22.19 (2OE); also elsewhere on the board
unnamed: R32.2, U22.3 (2Y0)
SDCLK_3V3: U22.7 (2Y2); also elsewhere on the board
SDCLK_5V: U22.13 (2A2); also elsewhere on the board
VCC: C31.1, C33.1, C34.1, J4.3, J4.4, J4.37, J4.38, U21.1 (VCC(A)); also elsewhere on the board
~SDCS_3V3: U22.9 (2Y3); also elsewhere on the board
~SDCS_5V: U22.11 (2A3); also elsewhere on the board

Notes on the sheet:
LCD panel connector
Near U21
Panel min V_OH = 2.4V PIO min V_IH = 2.2V Panel max V_OL = 0.4V PIO max V_IL = 0.8V
Near U22
If neither ~RD~ nor ~WR~ are active, then we must not drive the Z80 data bus. An IORQ interrupt cycle could drive this ~CS~ active, enabling transceiver outputs. We’re okay because ~RD~ will be inactive, so DIR will be high, making the A side inputs, and the B side outputs.

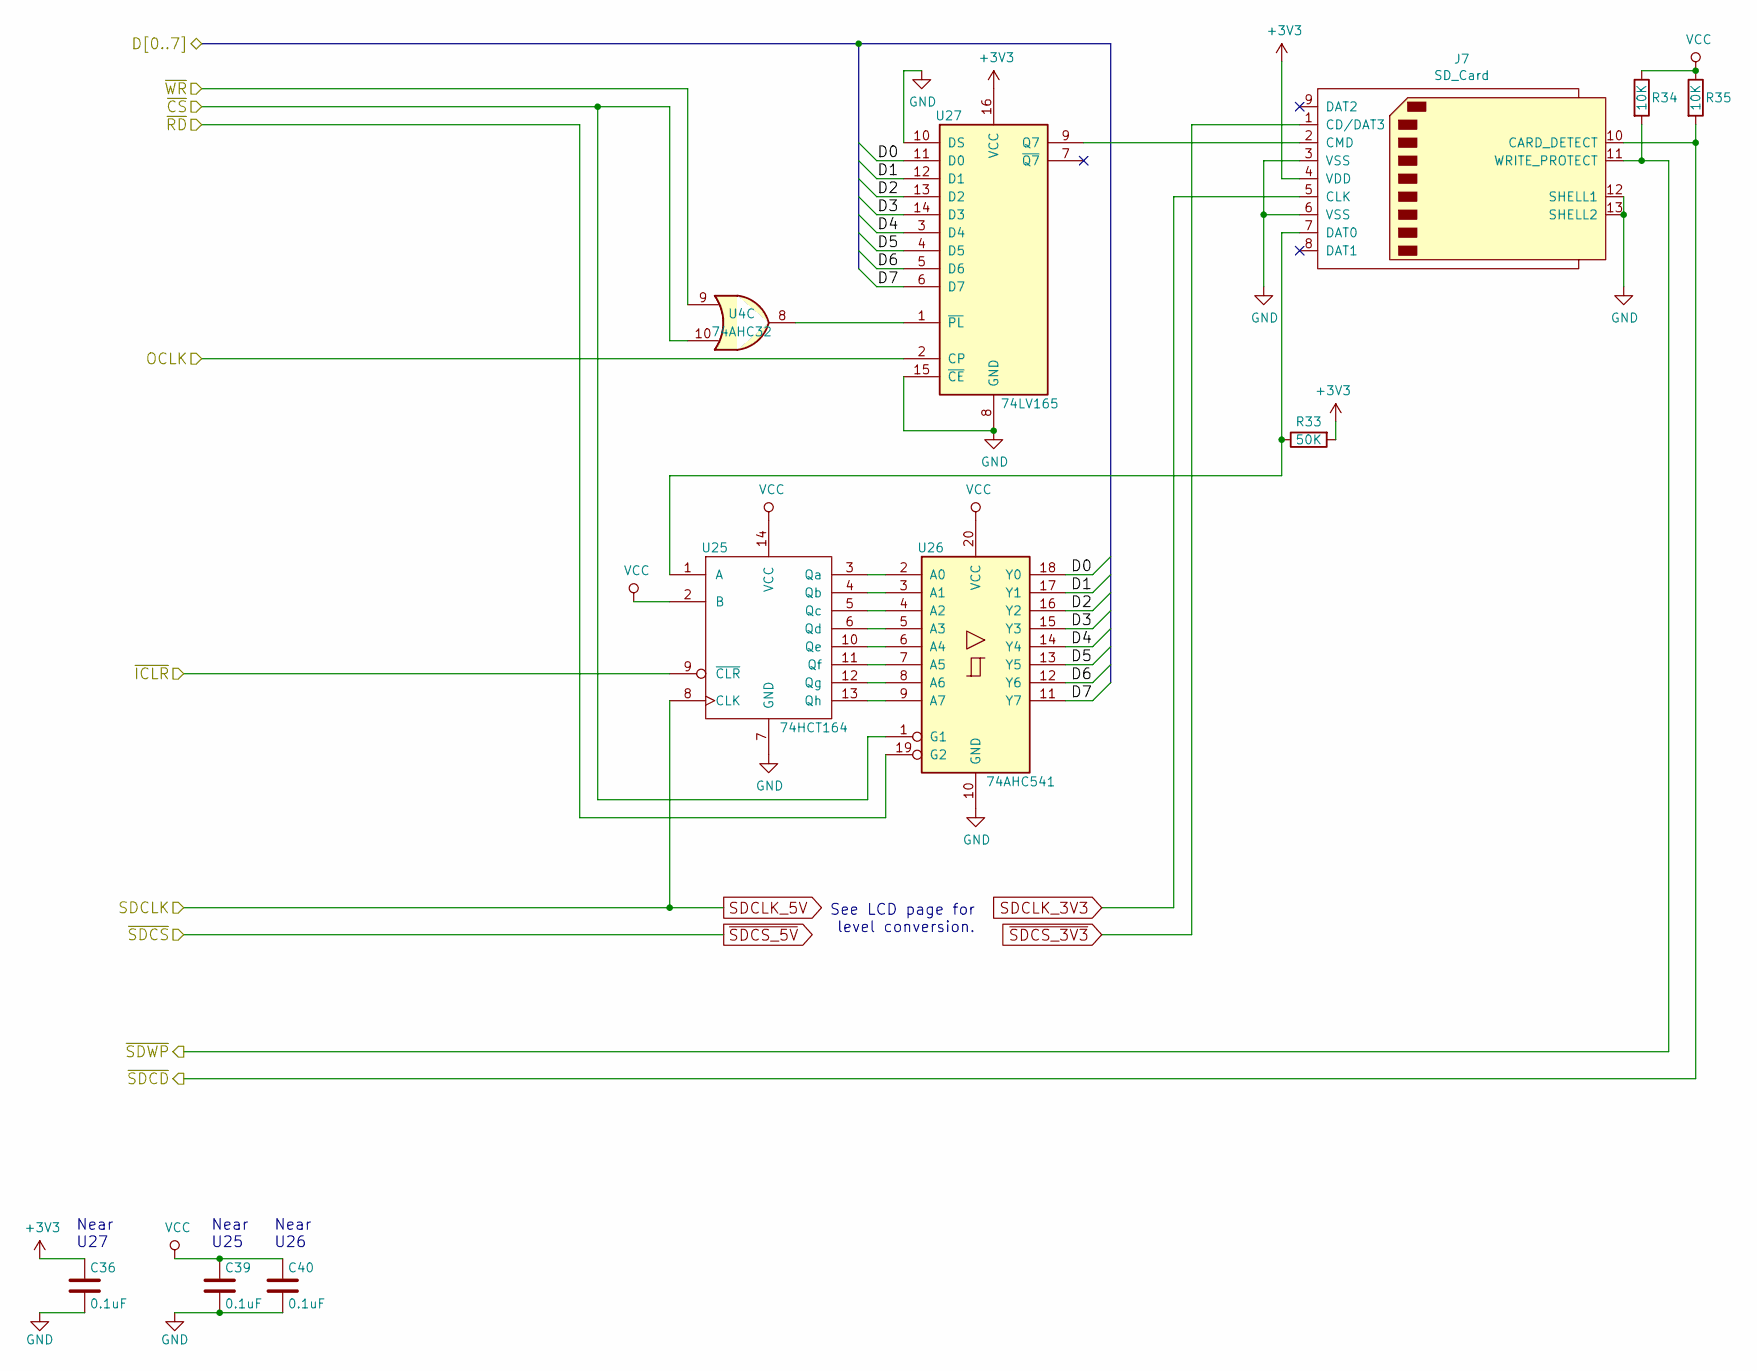
[picture p26: schematic SDcard.sch, SD Card Interface]

Parts:
C36, C39, C40: 0.1uF; C_Disc_D4.3mm_W1.9mm_P5.00mm
J7: SD_Card; 101-00405
R33: 50K; R_0805_HandSoldering
R34, R35: 10K; R_0805_HandSoldering
U4: 74AHC32; DIP-14_W7.62mm
U25: 74HCT164; TSSOP-14_4.4x5mm_Pitch0.65mm
U26: 74AHC541; TSSOP-20_4.4x6.5mm_Pitch0.65mm
U27: 74LV165; TSSOP-16_4.4x5mm_Pitch0.65mm

Connections:
+3V3: C36.1, J7.4 (VDD), R33.2, U27.16 (VCC); also elsewhere on the board
/D0: U26.18 (Y0), U27.11 (D0); also elsewhere on the board
/D1: U26.17 (Y1), U27.12 (D1); also elsewhere on the board
/D2: U26.16 (Y2), U27.13 (D2); also elsewhere on the board
/D3: U26.15 (Y3), U27.14 (D3); also elsewhere on the board
/D4: U26.14 (Y4), U27.3 (D4); also elsewhere on the board
/D5: U26.13 (Y5), U27.4 (D5); also elsewhere on the board
/D6: U26.12 (Y6), U27.5 (D6); also elsewhere on the board
/D7: U26.11 (Y7), U27.6 (D7); also elsewhere on the board
/Joystick Ports/~SDCD: J7.10 (CARD_DETECT), R35.2; also elsewhere on the board
/Joystick Ports/~SDWP: J7.11 (WRITE_PROTECT), R34.2; also elsewhere on the board
/SDOCLK: U27.2 (CP); also elsewhere on the board
/~IORQ8: U4.10, U26.1 (G1); also elsewhere on the board
/~RD: U26.19 (G2); also elsewhere on the board
/~SDICLR: U25.9 (~CLR); also elsewhere on the board
/~WR: U4.9; also elsewhere on the board
GND: C36.2, C39.2, C40.2, J7.3 (VSS), J7.6 (VSS), J7.12 (SHELL1), J7.13 (SHELL2), U25.7 (GND), U26.10 (GND), U27.8 (GND), U27.10 (DS), U27.15 (~CE); also elsewhere on the board
unnamed: J7.2 (CMD), U27.9 (Q7)
unnamed: J7.7 (DAT0), R33.1, U25.1 (A)
unnamed: U25.3 (Qa), U26.2 (A0)
unnamed: U25.4 (Qb), U26.3 (A1)
unnamed: U25.5 (Qc), U26.4 (A2)
unnamed: U25.6 (Qd), U26.5 (A3)
unnamed: U25.10 (Qe), U26.6 (A4)
unnamed: U25.11 (Qf), U26.7 (A5)
unnamed: U25.12 (Qg), U26.8 (A6)
unnamed: U25.13 (Qh), U26.9 (A7)
unnamed: U4.8, U27.1 (~PL)
SDCLK_3V3: J7.5 (CLK); also elsewhere on the board
SDCLK_5V: U25.8 (CLK); also elsewhere on the board
VCC: C39.1, C40.1, R34.1, R35.1, U25.2 (B), U25.14 (VCC), U26.20 (VCC); also elsewhere on the board
~SDCS_3V3: J7.1 (CD/DAT3); also elsewhere on the board

Notes on the sheet:
Near U27
See LCD page for level conversion.
Near U25
Near U26

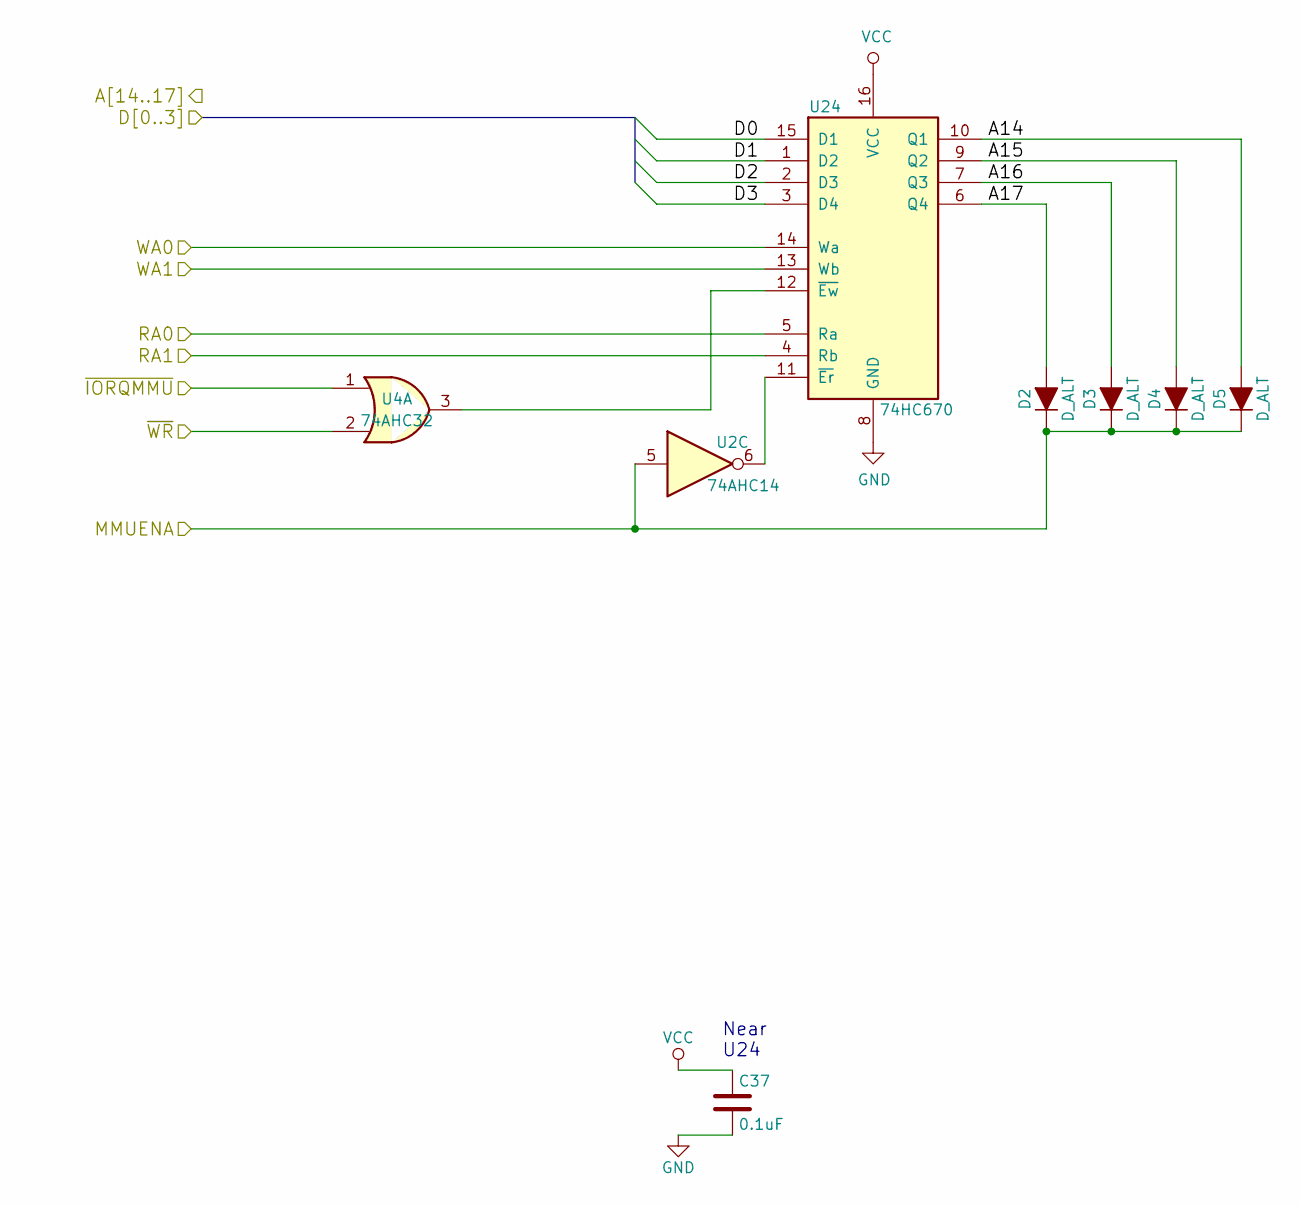
[picture p27: schematic MMU.sch, Memory Management Unit]

Parts:
C37: 0.1uF; C_Disc_D4.3mm_W1.9mm_P5.00mm
D2, D3, D4, D5: D_ALT; D_SOT-23_ANK
U2: 74AHC14; DIP-14_W7.62mm
U4: 74AHC32; DIP-14_W7.62mm
U24: 74HC670; SOIC-16_3.9x9.9mm_Pitch1.27mm

Connections:
/A0: U24.14 (Wa); also elsewhere on the board
/A1: U24.13 (Wb); also elsewhere on the board
/A14: U24.5 (Ra); also elsewhere on the board
/A15: U24.4 (Rb); also elsewhere on the board
/D0: U24.15 (D1); also elsewhere on the board
/D1: U24.1 (D2); also elsewhere on the board
/D2: U24.2 (D3); also elsewhere on the board
/D3: U24.3 (D4); also elsewhere on the board
/MMUEN: D2.1 (K), D3.1 (K), D4.1 (K), D5.1 (K), U2.5; also elsewhere on the board
/PA14: D5.2 (A), U24.10 (Q1); also elsewhere on the board
/PA15: D4.2 (A), U24.9 (Q2); also elsewhere on the board
/PA16: D3.2 (A), U24.7 (Q3); also elsewhere on the board
/PA17: D2.2 (A), U24.6 (Q4); also elsewhere on the board
/~IORQ6: U4.1; also elsewhere on the board
/~WR: U4.2; also elsewhere on the board
GND: C37.2, U24.8 (GND); also elsewhere on the board
unnamed: U2.6, U24.11 (~Er)
unnamed: U4.3, U24.12 (~Ew)
VCC: C37.1, U24.16 (VCC); also elsewhere on the board

Notes on the sheet:
Near U24

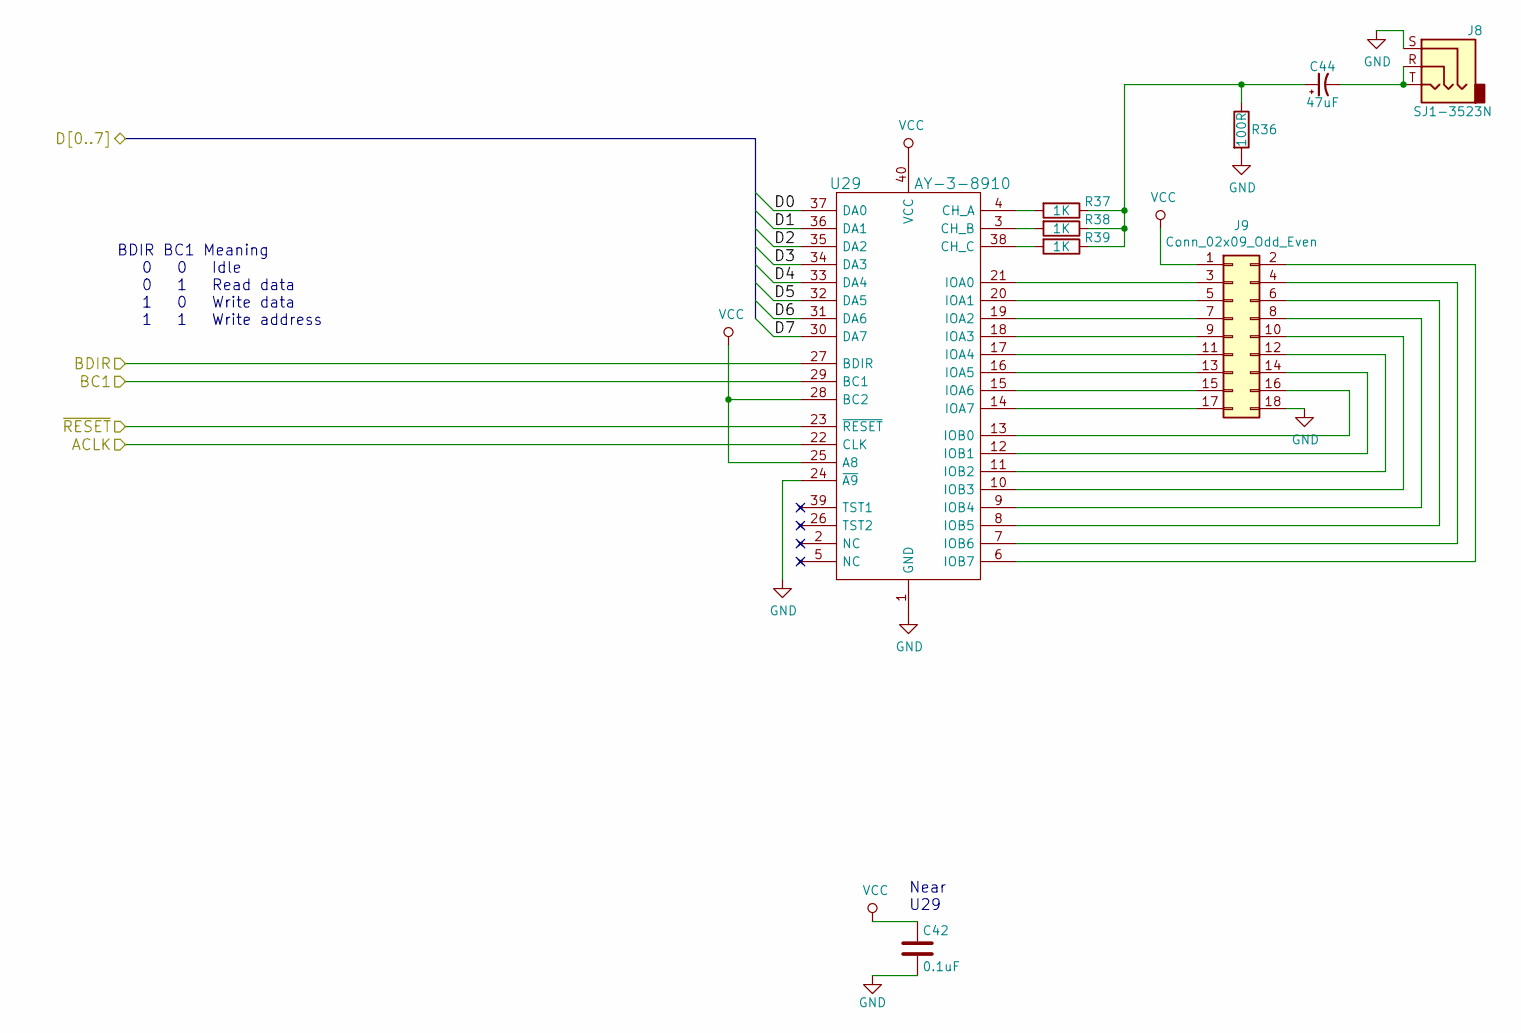
[picture p28: schematic audio.sch]

Parts:
C42: 0.1uF; C_Disc_D4.3mm_W1.9mm_P5.00mm
C44: 47uF; CP_Radial_D6.3mm_P2.50mm
J8: SJ1-3523N
J9: Conn_02x09_Odd_Even; Pin_Header_Straight_2x09_Pitch2.54mm
R36: 100R; R_0805_HandSoldering
R37, R38, R39: 1K; R_0805_HandSoldering
U29: AY-3-8910; DIP-40_W15.24mm_Socket

Connections:
/Audio/D0: U29.37 (DA0); also elsewhere on the board
/Audio/D1: U29.36 (DA1); also elsewhere on the board
/Audio/D2: U29.35 (DA2); also elsewhere on the board
/Audio/D3: U29.34 (DA3); also elsewhere on the board
/Audio/D4: U29.33 (DA4); also elsewhere on the board
/Audio/D5: U29.32 (DA5); also elsewhere on the board
/Audio/D6: U29.31 (DA6); also elsewhere on the board
/Audio/D7: U29.30 (DA7); also elsewhere on the board
/BC1: U29.29 (BC1); also elsewhere on the board
/BDIR: U29.27 (BDIR); also elsewhere on the board
/CLK2M: U29.22 (CLK); also elsewhere on the board
/~RESET: U29.23 (~RESET); also elsewhere on the board
GND: C42.2, J8.S, J9.18, R36.2, U29.1 (GND), U29.24 (~A9); also elsewhere on the board
unnamed: C44.1, R36.1, R37.1, R38.1, R39.1
unnamed: C44.2, J8.R, J8.T
unnamed: J9.2, U29.6 (IOB7)
unnamed: J9.3, U29.21 (IOA0)
unnamed: J9.4, U29.7 (IOB6)
unnamed: J9.5, U29.20 (IOA1)
unnamed: J9.6, U29.8 (IOB5)
unnamed: J9.7, U29.19 (IOA2)
unnamed: J9.8, U29.9 (IOB4)
unnamed: J9.9, U29.18 (IOA3)
unnamed: J9.10, U29.10 (IOB3)
unnamed: J9.11, U29.17 (IOA4)
unnamed: J9.12, U29.11 (IOB2)
unnamed: J9.13, U29.16 (IOA5)
unnamed: J9.14, U29.12 (IOB1)
unnamed: J9.15, U29.15 (IOA6)
unnamed: J9.16, U29.13 (IOB0)
unnamed: J9.17, U29.14 (IOA7)
unnamed: R37.2, U29.4 (CH_A)
unnamed: R38.2, U29.3 (CH_B)
unnamed: R39.2, U29.38 (CH_C)
VCC: C42.1, J9.1, U29.25 (A8), U29.28 (BC2), U29.40 (VCC); also elsewhere on the board

Notes on the sheet:
BDIR BC1 Meaning 0 0 Idle 0 1 Read data 1 0 Write data 1 1 Write address
Near U29

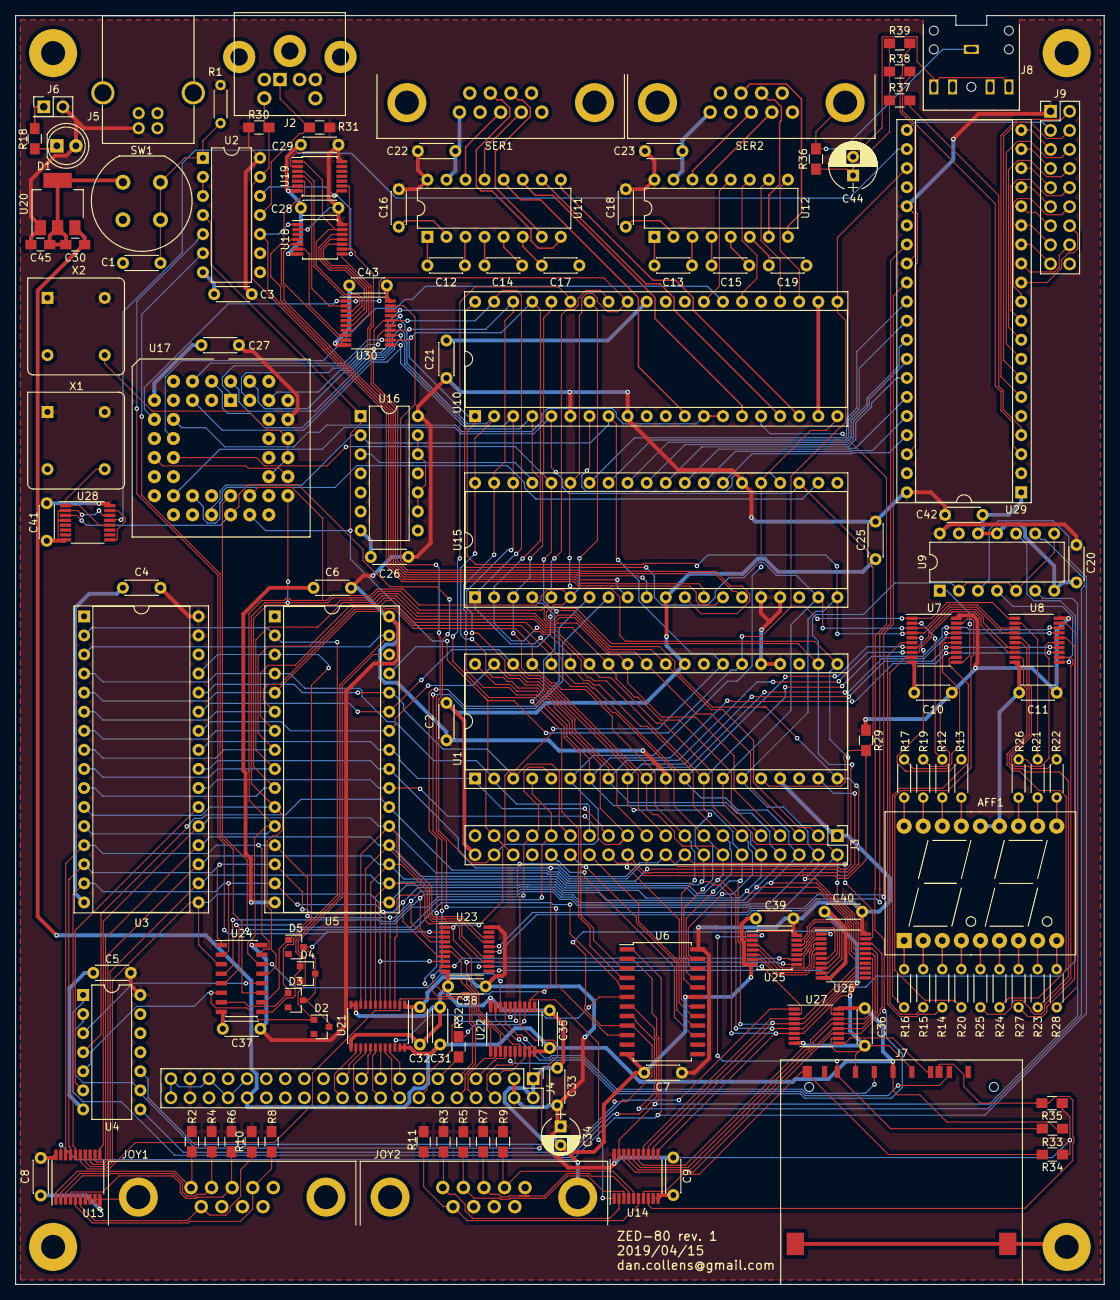
[picture p29: board zed-80.kicad_pcb from above]

Board: 2 copper layers, 145.0 x 169.0 mm, 138 parts (0 on the bottom side), 225 nets.
