dcollens/ZED-80/(commit log)

2017-10-23 Initial checkin of z80 prototype project.
    [51846558.xlsx, 7-Segment Display.sch, CTC.sch, PIO.sch, SIO.sch, joystick.sch, z80.kicad_pcb, z80.sch]
2017-11-05 Latest rev of z80 schematic.
    [7-Segment Display.sch, CTC.sch, PIO.sch, SIO.sch, joystick.sch, spares.sch, z80.sch]
2018-03-28 Add expansion bus connector; rev 6.
    [7-Segment Display.sch, CTC.sch, PIO.sch, SIO.sch, joystick.sch, spares.sch, z80.sch]
2018-04-11 Assign footprints to schematic, drawing custom connector, socket, and switch footprints as needed.
    [7-Segment Display.sch, CTC.sch, PIO.sch, SIO.sch, joystick.sch, spares.sch, z80.sch]
2018-05-10 Completed first pass of board layout.
    [7-Segment Display.sch, CTC.sch, PIO.sch, SIO.sch, joystick.sch, spares.sch, z80.csv, z80.sch]
2018-05-31 Initial prototype PCB build.
    [7-Segment Display.sch, CTC.sch, PIO.sch, SIO.sch, joystick.sch, spares.sch, z80.kicad_pcb, z80.sch]
2018-06-12 Clean up and archive everything for revision 8.
    [z80.csv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]
2018-06-12 Fix footprint for C24 to be a polarized radial electrolytic THT capacitor.
    [z80.kicad_pcb, z80.sch]
2018-06-13 Update schematic & layout to fix reversed keyboard port pinout. Update test programs for PCB. Write test code for joystick port.
    [7-Segment Display.sch, CTC.sch, PIO.sch, SIO.sch, joystick.sch, spares.sch, z80.kicad_pcb, z80.sch]
2018-06-14 Add support for CTC chip; enable timer interrupts in test programs.
2018-07-16 Docs for LCD module.
    [RA8876.OBJ, sd.OBJ]
2018-07-18 Schematic for an LCD panel interface circuit.
    [7-Segment Display.sch, CTC.sch, LCD.sch, PIO.sch, SIO.sch, joystick.sch, spares.sch, z80.sch]
2018-10-13 Port NASCOM BASIC to the prototype Z80 board. Get Super Star Trek BASIC program running.
2018-10-16 Latest updates; preparing to move to github (I think).
    [7-Segment Display.sch, CTC.sch, LCD.sch, MMU.sch, PIO.sch, SIO.sch, joystick.sch, spares.sch]
2018-10-26 Move Kicad files into a subfolder.
    [7-Segment Display.sch, CTC.sch, LCD.sch, MMU.sch, PIO.sch, SIO.sch, joystick.sch, spares.sch]
2018-11-06 First cut at ZED-80 emulator. Only output so far is to terminal.
2018-12-23 Update to Kicad 5
    [7-Segment Display-2018-12-23-11-22-52.sch, 7-Segment Display.sch, CTC-2018-12-23-11-22-52.sch, CTC.sch, LCD-2018-12-23-11-22-52.sch, MMU-2018-12-23-11-22-52.sch, PIO-2018-12-23-11-22-52.sch, PIO.sch]
2019-01-17 Working on SD card interface, cleaning up.
    [7-Segment Display.sch, CTC.sch, LCD.sch, MMU.sch, PIO.sch, SDcard.sch, SIO.sch, joystick.sch]
2019-03-01 SDcard interface mostly complete.
    [7-Segment Display.sch, LCD.sch, PIO.sch, SDcard.sch, power_reset_spares.sch, z80.sch]
2019-03-22 Hook up SD card slot's write protect and card detect lines.
    [SDcard.sch, joystick.sch, z80.sch]
2019-04-02 Add audio output.
    [7-Segment Display.sch, CTC.sch, LCD.sch, MMU.sch, PIO.sch, SDcard.sch, SIO.sch, audio.sch]
2019-04-02 Clean up old backup files.
    [7-Segment Display-2018-12-23-11-22-52.sch, CTC-2018-12-23-11-22-52.sch, LCD-2018-12-23-11-22-52.sch, MMU-2018-12-23-11-22-52.sch, PIO-2018-12-23-11-22-52.sch, SIO-2018-12-23-11-22-52.sch, joystick-2018-12-23-11-22-52.sch, spares-2018-12-23-11-22-52.sch]
2019-04-02 Rename Kicad project from "z80" to "zed-80".
    [zed-80.kicad_pcb, zed-80.sch]
2019-04-03 First complete version of ZED-80 schematic.
    [7-Segment Display.sch, CTC.sch, LCD.sch, MMU.sch, PIO.sch, SDcard.sch, SIO.sch, audio.sch]
2019-04-11 Assign footprints.
    [7-Segment Display.sch, LCD.sch, MMU.sch, PIO.sch, SDcard.sch, SIO.sch, audio.sch, joystick.sch]
2019-04-11 Add SD card footprint.
    [7-Segment Display.sch, CTC.sch, LCD.sch, MMU.sch, PIO.sch, SDcard.sch, SIO.sch, audio.sch]
2019-04-16 First pass layout of revised board complete.
    [7-Segment Display.sch, CTC.sch, LCD.sch, MMU.sch, PIO.sch, SDcard.sch, SIO.sch, audio.sch]
2019-04-16 Finalize layout of ZED-80 rev. 1
    [zed-80.kicad_pcb]
2019-04-16 Archive build files for ZED-80 rev1
    [z80r8-B.Cu.gbr, z80r8-B.Mask.gbr, z80r8-B.SilkS.gbr, z80r8-Edge.Cuts.gbr, z80r8-F.Cu.gbr, z80r8-F.Mask.gbr, z80r8-F.SilkS.gbr, z80r8.drl]
2019-04-28 Hide footprint value on schematic.
    [LCD.sch]
2019-04-29 Move old Z80 software to z80-prototype folder, as it depends on the memory map of the prototype board. Create new zed-80 folder for software for the real ZED-80 board, and start copying/updating some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
2019-04-29 Check in ZED-80 BOM files.
    [zed-80-bom.csv]
2019-04-30 Port ROM monitor to ZED-80. Port "ram_test.asm" to ZED-80 (currently a joystick test), which can be loaded by serial port into RAM by the monitor.
2019-04-30 Refactor board parts into ZED80 class.
2019-05-01 Switch to the HeadCode team so that LK and I can both develop without having to manually switch back and forth between our respective personal teams.
2019-05-16 Check in RA8876 sample reference code (incl. preprocessed version).
2019-05-17 Flesh out LCD panel support in the emulator. Fix bug in MMU which discarded offset within page on all accesses when MMU enabled. Allow loading of arbitrary regions of ROM and RAM from multiple files 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
    [io_lcdpanel.h, mmu.hpp, ra8876.cpp, ra8876.h, zed-80.hpp]
2019-05-22 Ignore *.pkt files (these are binary files formatted for transmission over the serial port to the ROM monitor), since they are build products too. Rename call-4000.pkt to call-4000-pkt so it won't be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
2019-05-22 Emulate the CTC, including timer interrupts.
2019-05-22 Simulate PIO chip (not yet connected to any downstream devices).
2019-05-23 Emulate AY-3-8910, including audio output to host. Switch to rom_ram_test.rom so you can hear the boot sound.
2019-05-24 Add Reset menu item.
    [io_sysreg.h, iommu.h, zed-80.h]
2019-05-24 Clean up the keycode map for the emulator. Implement a polling-mode keyboard driver for the ZED-80, and attach it to the LCD so you can type (unmodified) keys and see them echo back on the LCD. Still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
2019-05-24 Correctly implement emulator reset, apart from re-loading RAM contents from input file.
    [audiodevice.h, io_ctc.h, io_joyseg.h, io_lcdpanel.h, io_pio.h, ra8876.cpp, ra8876.h]
2019-05-24 Implement extended keycodes (ones that start $E0) in the ZED-80 keyboard driver.
2019-05-25 Only call iommu if doing read or write.
    The previous code was calling the iommu if the IORQ line
    was asserted, but (apparently!) the address pins are not
    valid at this time, and the iommu was dispatching to
    a bogus device. (The symptom was a warning for IO access
    to the unimplemented SD card $80.) Added a check to
    read or write before dispatching to iommu.
    Also added a debug print when writing to the ROM. The
    PC and the bus pins are dumped to cout. This is to
    help debug a problem where the ROM is being written
    to in a part of the code that's not doing any writes.
2019-05-25 Add pin history for debugging.
2019-05-25 Keep track of cursor position.
2019-05-25 Add decimal and hex printing routines.
2019-05-25 Rename gets() to lcd_gets() for now to make it clear that it operates on the console and not serial port. Maybe this should be called kbd_gets, or maybe con_gets (for "console") since it uses the loc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
2019-05-26 Tidy up the pin history code; use it to find the last few port 0x2x IORQs.
2019-05-26 Silence some warnings from the RA8876 driver.
2019-06-02 Refactor assembly language source into libraries.
2019-06-03 Fix schematic so that ~SDWP signal is named SDWP instead, as it is active high, not active low. There is no change to connectivity, this is only a descriptive fix.
    [7-Segment Display.sch, CTC.sch, LCD.sch, MMU.sch, PIO.sch, SDcard.sch, SIO.sch, audio.sch]
2019-06-13 Get serious about real-time emulation, so that the rate at which we fill the audio buffers closely matches the rate at which audio is consumed by the audio output driver. Delay the start of audio pla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
    The beep sound now plays correctly.
    [audiodevice.h, zed-80.h]
2019-10-13 Make a version of the BASIC interpreter that loads low (i.e. address 0), and store it in the ROM. Add a monitor command to load and run the BASIC interpreter. (Uses bank switching to copy the BASIC f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
2019-12-08 First cut at SD card emulation.
2019-12-24 Add test programs to study power anomaly.
2020-02-06 New ROM monitor for Z80 prototype board that includes the BASIC interpreter.
2020-03-05 Hook up emulator's PIO interrupt support so we can test interrupt-driven keyboard I/O, and connect the PIO and KBD device emulations correctly. Start work on kbd_test.asm test program that implements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
    [io_keyboard.h, io_pio.h]
2020-03-14 Split keyboard driver into polling-mode and interrupt-mode variants. Use interrupt-driven keyboard driver for ROM monitor and kbd_test program, but leave BASIC, Forth, and CP/M using polling-mode for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
2020-03-14 Switch BASIC, Forth, and CP/M over to interrupt-driven keyboard driver.
2020-03-15 Ensure static data is zeroed out at startup so the keyboard driver doesn't think there's junk in the ring buffer.
2020-04-20 Protect use of Sysreg in ZASM code, including CBIOS, with ei/di. Lay groundwork for same from CP/M C library, but no need to finish that until we have a means to hook the CTC ISR.
2020-10-25 CBIOS: add SETCTCISR entry point to set CTC ISRs ymplay: set 50Hz CTC timer tick and use it to sync playback
2020-10-25 ymplay: add a missed frames counter
2020-10-26 CPM/SDCC: update to SDCC 4.0.0 which includes a strdup() implementation in its C library, so drop ours. CBIOS: add a SNDWRITE entry point to write data to the sound chip Rework the assembly code for 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
2020-11-11 Implement CBIOS routine to load sound chip registers (instead of doing it from userland directly). Remove CP/M C library routines for banging on sound chip directly using SYSREG. Update YMPLAY to use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
2020-11-19 YMPLAY: stop playback early if ESC key pressed
2020-11-19 C-library: provide access to all CP/M console I/O entry points, including "direct" I/O. YMPLAY: use direct console I/O to respond to ESC and 'q' to quit playback
2020-11-22 YMPLAY: play multiple tracks, and switch between them
2020-11-29 Add a bunch more YM files to the SD card image. Replace the SDCC C library's statically-sized heap implementation with one that uses all the available space between the the top of code/data and the b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
2020-12-06 CHIP8: first cut at CHIP-8 emulator with passing opcode test Still need sound, keyboard, and proper display
2020-12-13 CBIOS: add setrawmode extension to toggle raw/cooked keyboard input CPM: add KEYTEST app to test raw/cooked keyboard input CHIP8: implement keyboard support (untested), and automatically update displ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
2020-12-13 Update Kicad files to 5.1.8
    [7-Segment Display.sch, CTC.sch, LCD.sch, MMU.sch, PIO.sch, SDcard.sch, SIO.sch, audio.sch]
2021-01-24 CHIP8: wait for a tick at every sprite DRW operation to throttle the emulation speed
